HoHiep228/Project_Design-and-implementation-of-an-amplifier-circuit/Report_Design and implementation of an amplifier circuit..pdf

### ĐẠI HỌC QUỐC GIA THÀNH PHỐ HỒ CHÍ MINH

### TRƯỜNG ĐẠI HỌC BÁCH KHOA

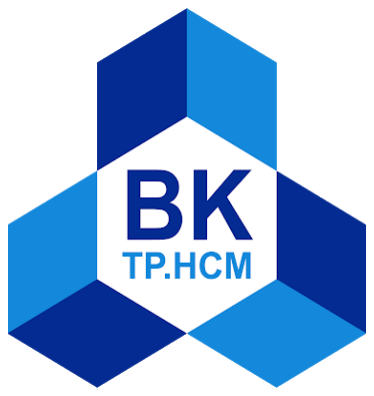
[picture p1: figure]

### BÁO CÁO BÀI TẬP LỚN MẠCH ĐIỆN TỬ

### THIẾT KẾ, THI CÔNG VÀ MÔ PHỎNG MẠCH KHUẾCH ĐẠI

Đáp ứng yêu cầu sau:

Trở kháng ngõ vào: > 100K.
Trở kháng ngõ ra: < 1K.
Nguồn ngõ vào trở kháng 1K, biên độ max 1Vpp.

Độ lợi áp: 5.
Băng thông: 15 Hz - 15 KHz.

Lớp: L01 - Nhóm: 07 - Học kỳ: 232

Giảng viên hướng dẫn: Đinh Quốc Hùng

Họ và tên | MSSV | Công việc | Đánh giá
Phạm Võ Hiệp | 2211051 | Lắp mạch thực tế | 25%
Phạm Lộ Hoàng Khang | 2211464 | Tính toán thiết kế | 25%
Nguyễn Đức Mạnh | 2211997 | Mô phỏng thiết kế | 25%
Trần Kim Phát | 2212536 | Báo cáo tổng hợp | 25%

Thành phố Hồ Chí Minh, ngày 23 tháng 04 năm 2024

## MỤC LỤC

PHẦN II. THIẾT KẾ, THI CÔNG VÀ MÔ PHỎNG MẠCH KHUẾCH ĐẠI.......8

1

### LỜI NÓI ĐẦU

Mạch điện tử là một trong những môn cơ sở ngành thể hiện vai trò vô cùng to

lớn để ứng dụng và phát triển chuyên sâu vào những môn chuyên ngành phía sau. Có

thể nói ở thời đại 4.0 này, hàng loạt các công nghệ hiện đại, phức tạp đều có một điểm

chung đó chính là phát triển từ các mạch điện tử cơ bản. Chỉ những linh kiện điện tử

bé nhỏ, nhưng đã thực hiện được hàng loạt các cuộc cách mạng trên toàn thế giới. Qua

các cuộc cách mạng công nghiệp, các linh kiện điện tử ngày càng được ứng dụng trong đời sống sản xuất cũng như sinh hoạt thường ngày.

Chính vì sự quan trọng ấy, nhóm chúng em vận dụng những kiến thức được học

tại lớp nhằm thực hiện bài tập lớn về thiết kế mạch khuếch đại. Mạch khuếch đại

thường được ứng dụng nhiều trong nhiều thiết bị, nhưng điển hình nhất, gần gũi nhất

với chúng ta đó chính là Ampli.

Vì thế, nhóm chúng em đã lên ý tưởng và bắt đầu tiến hành thiết kế mạch

khuếch đại này theo yêu cầu của đề tài được giao đó chính là:

- Trở khác ngõ vào: > 100K.
- Trở kháng ngõ ra: < 1K.
- Nguồn ngõ vào trở kháng 1K, biên độ max 1Vpp.
- Độ lợi áp: 5.
- Băng thông: 15 Hz - 15 KHz.

Trong quá trình báo cáo bài tập lớn cùng với việc thiết kế, thi công và mô

phỏng mạch khuếch đại sẽ không tránh những sai xót đang có. Do đó, nhóm chúng em

mong thầy sẽ đưa ra những lời nhận xét, để bài tập lớn này có thể hoàn thành đúng

như kỳ vọng cũng như được học hỏi thêm nhiều kiến thức áp dụng thực tế mai sau.

### PHẦN I

### CƠ SỞ LÝ THUYẾT

Mạch khuếch đại là mạch gồm các linh kiện điện tử cơ bản và một vài linh kiện

điện tử khác có chức năng khuếch đại cấu thành nên. Khi xuất hiện một tín hiệu từ ngõ

vào của mạch khuếch đại là dòng điện hoặc là điện áp, các linh kiện transistor thực

hiện công việc khuếch đại tín hiệu ngõ vào, sau đó tín hiệu đã được khuếch đại sẽ

được đưa ra ngõ ra và nối vào các ngoại vi tùy nhu cầu người thiết kế. Các phần tử

transistor dùng trong mạch khuếch đại chủ yếu là BJT, FET,... Hiện nay, để thiết kế

mạch khuếch đại, chúng ta có thể sử dụng nhiều phương pháp phụ thuộc vào nhu cầu

của người thiết kế có thể kể đến như: Mạch khuếch đại vi sai, mạch khuếch đại liên

tầng, ... Và nhóm chúng em quyết định sử dụng BJT để thực hiện bài tập lớn này, khi

sử dụng BJT, chúng ta cần phải quan tâm chú ý đến điểm làm việc tĩnh của loại BJT

lựa chọn sử dụng. Và để ứng dụng tính khuếch đại của BJT, ta cần thiết kế sao cho

điểm làm việc tĩnh này nằm trong vùng active mode.

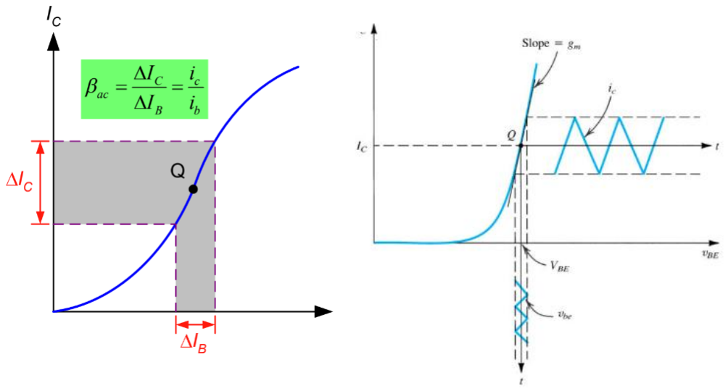
[picture p2: figure]

Ta đi vào tiến hành phân tích một số mạch khuếch đại sử dụng BJT.

1. Mạch khuếch đại cực E chung (Common Emmiter - CE).

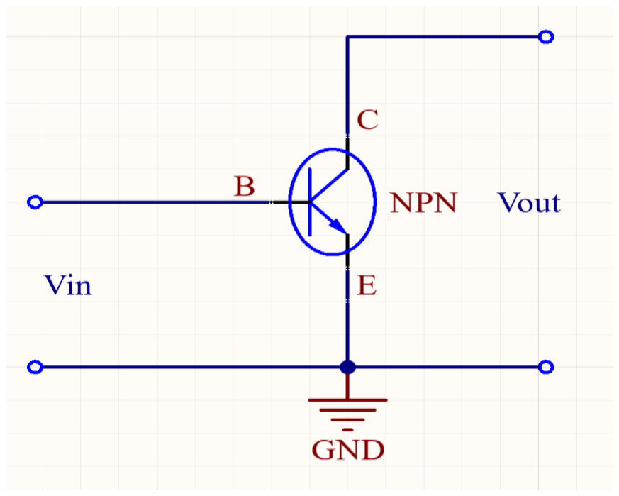
[picture p3: figure]

Mạch mắc theo kiểu cực E chung có các đặc điểm sau:

- Trở kháng ngõ vào (Rin) nhỏ.
- Trở kháng ngõ ra (Rout) lớn.
- Tín hiệu ngõ vào (Vin) là cực B.
- Tín hiệu ngõ ra (Vout) là cực C.
- Tín hiệu ngõ ra ngược pha so với tín hiệu ngõ vào.
- Khi mắc cực E chung, transistor có khả năng khuếch đại dòng điện, khuếch

đại điện áp, và khuếch đại công suất.

2. Mạch khuếch đại cực B chung (Common Base - CB).

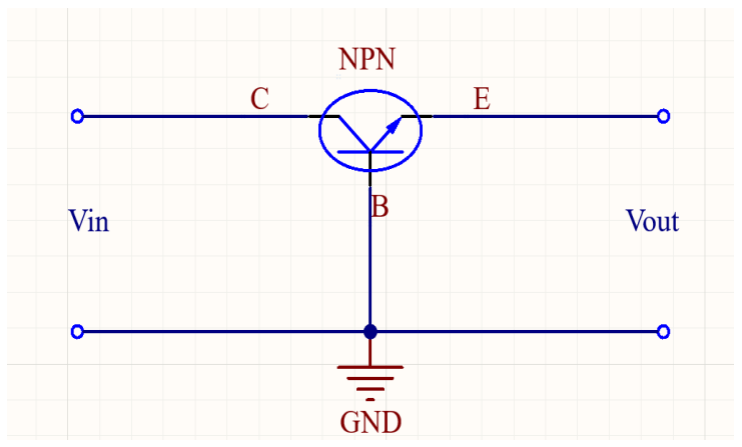
[picture p4: figure]

Mạch mắc theo kiểu cực B chung có các đặc điểm sau:

- Trở kháng ngõ vào (Rin) lớn.
- Trở kháng ngõ ra (Rout) lớn.

- Tín hiệu ngõ vào (Vin) là cực E.
- Tín hiệu ngõ ra (Vout) là cực C.
- Tín hiệu ngõ ra cùng pha so với tín hiệu ngõ vào.
- Khi mắc cực B chung, transistor có khả năng khuếch đại điện áp.
3. Mạch khuếch đại cực C chung (Common Collector - CC).

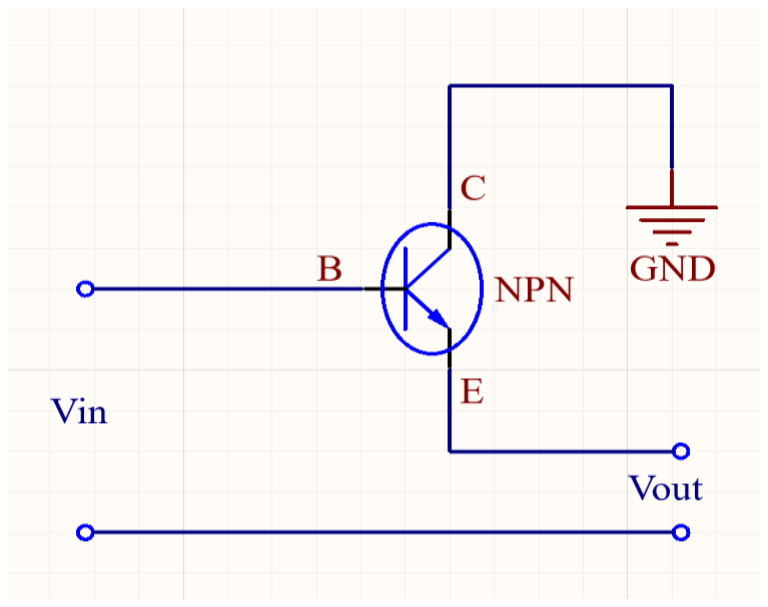
[picture p5: figure]

Mạch mắc theo kiểu cực C chung có các đặc điểm sau:

- Trở kháng ngõ vào (Rin) lớn.
- Trở kháng ngõ ra (Rout) nhỏ.
- Tín hiệu ngõ vào (Vin) là cực B.
- Tín hiệu ngõ ra (Vout) là cực E.
- Tín hiệu ngõ ra cùng pha so với tín hiệu ngõ vào.
- Khi mắc cực C chung, transistor có khả năng khuếch đại dòng điện.
4. Mạch khuếch đại ghép liên tầng.

Trong thực tế, việc sử dụng một mạch khuếch đại đơn có thể không đáp ứng đủ

độ lợi theo yêu cầu. Ví dụ, một hệ thống loa trong hệ thống khuếch đại âm thanh có

chứa nhiều mạch khuếch đại liên tầng nhằm để nâng mức tín hiệu gốc từ microphone

lên đến mức hiệu quả để cho ra một công suất đủ lớn tại loa. Sau đây là sơ đồ khối mô

tả mạch khuếch đại ghép liên tầng:

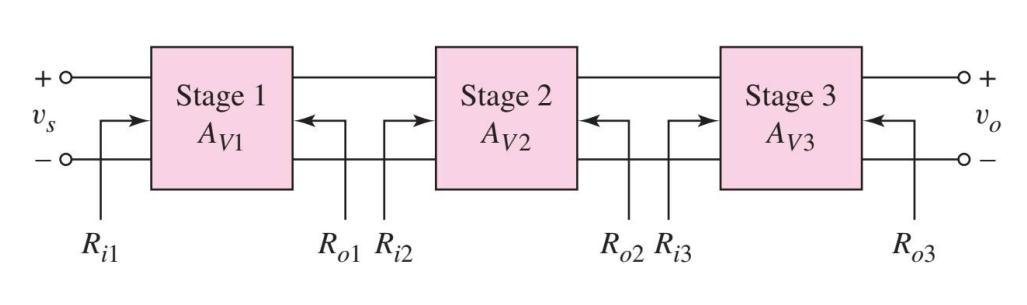
[picture p6: figure]

Một số mạch khuếch đại ghép liên tầng như: Mạch khuếch đại Cascade, mạch

khuếch đại Cascode, mạch khuếch đại Darlington, mạch khuếch đại vi sai.

4.1. Mạch khuếch đại Cascade.

Là mạch gồm nhiều mạch khuếch đại nối tiếp với nhau. Ngõ ra của mạch

khuếch đại này là ngõ vào của mạch khuếch đại tiếp theo.

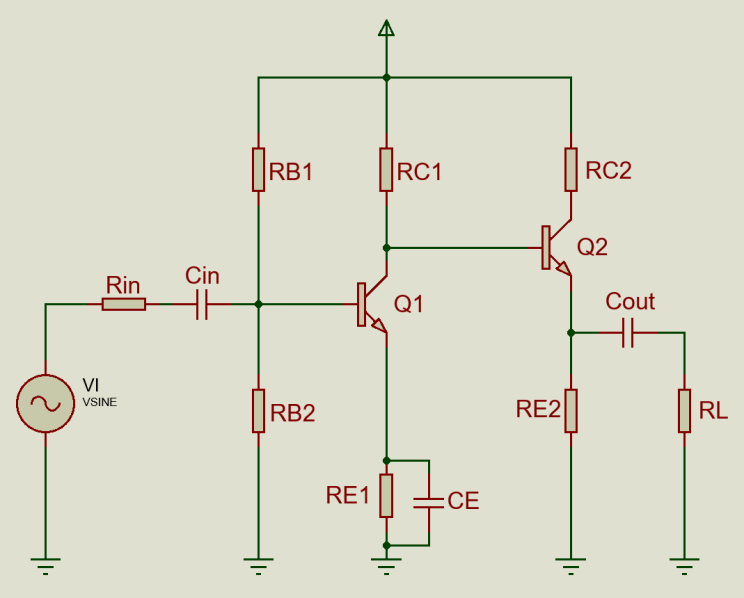
[picture p7: figure]

4.2. Mạch khuếch đại Cascode.

Là mạch ghép từ một mạch khuếch đại CE và một mạch khuếch đại CB. Tín

hiệu vào cấp cho mạch CE, tín hiệu ra lấy từ mạch CB. Ưu điểm lớn nhất của mạch là

có đáp ứng tần số tốt hơn các kiểu mạch ghép khác, cũng như tốt hơn mạch khuếch đại

đơn tầng.

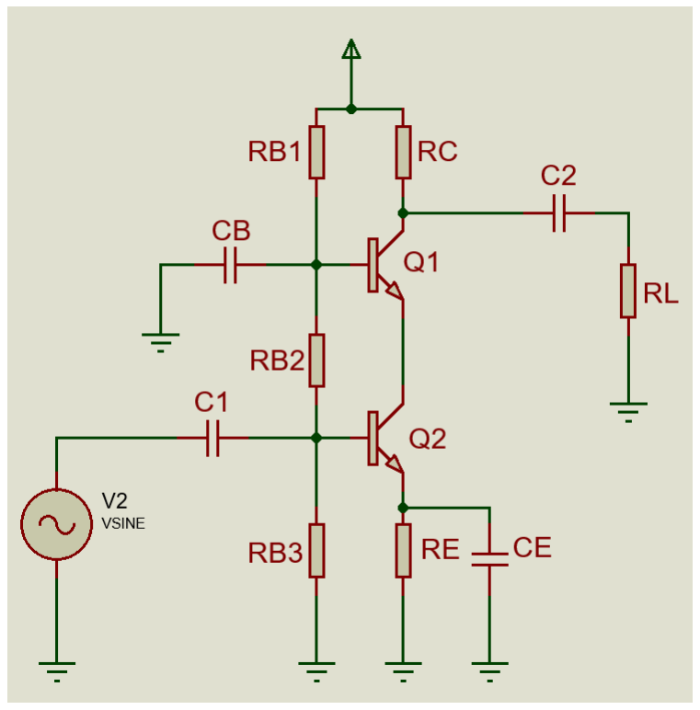
[picture p8: figure]

4.3. Mạch khuếch đại Darlington.

Là mạch dùng 2 BJT ghép chung và cực E của BJT này ghép nối tiếp với cực B

của BJT kia. Có thể xem như tương đương với 1 BJT với hfe = β1β2

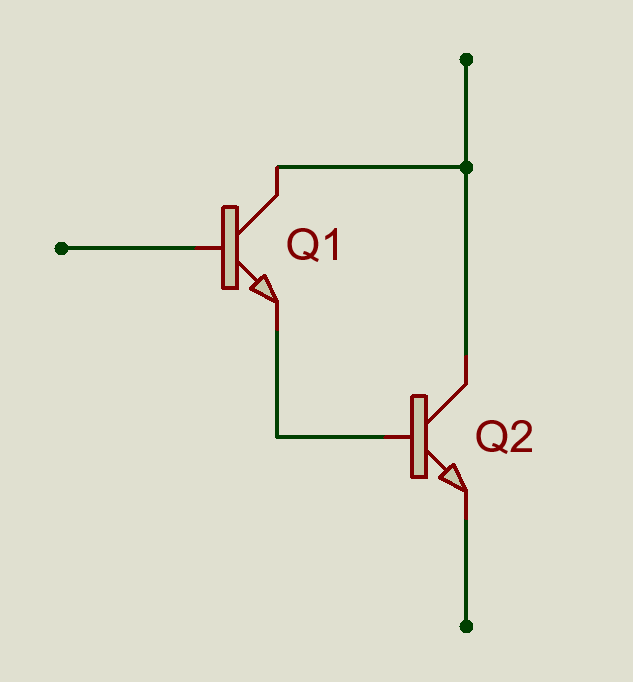
[picture p9: figure]

4.4. Mạch khuếch đại vi sai.

Là mạch gồm 2 BJT hoàn toàn giống nhau về mặt giá trị cũng như thông

số ngõ vào ngõ ra (mạch đối xứng). Nguồn dòng cực E xem như nguồn dòng lý

tưởng với trở khánh → ∞. Có thể sử dụng RE thay cho cho nguồn dòng.

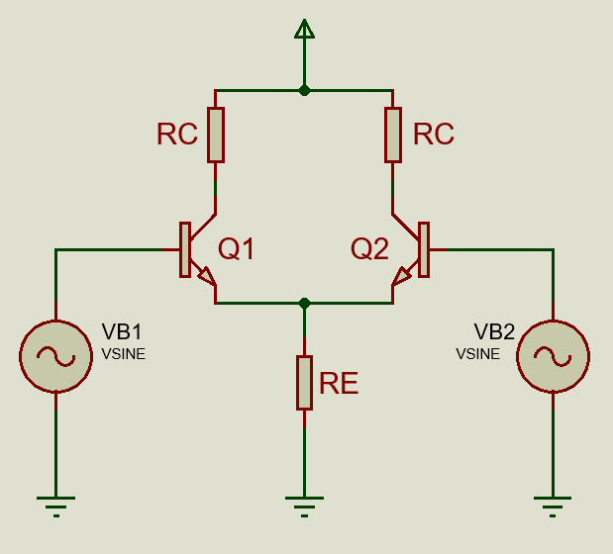
[picture p10: figure]

5. Khái niệm ghép RC.

Khi ta ghép các tụ, các tụ sẽ có chức năng chính đó là cho nguồn xoay chiều đi

qua, cách ly nguồn DC giữa các tầng ghép, và tạo tần số đủ cao để giữ cho giá trị điện

kháng XC nhỏ. Nhưng khi ta ghép RC, nó sẽ tác động đến những tín hiệu có tần số thấp,

sẽ xuất hiện những tổn hao xảy ra trên những tụ điện này, và vì thế cần phải lựa chọn

tụ có điện dung lớn và một tần số cắt thấp nhỏ.

### PHẦN II

### THIẾT KẾ, THI CÔNG VÀ MÔ PHỎNG MẠCH KHUẾCH ĐẠI

1. Thiết kế, thi công mạch khuếch đại theo yêu cầu đề bài.

Sau khi phân tích phần cơ sở lý thuyết nêu trên, nhóm chúng em đã quyết định

thiết kế mạch theo sơ đồ mạch khuếch đại Cascade. Để thiết kế một mạch khuếch đại

dùng BJT, ta cần nắm rõ tính toán các thông số của BJT phù hợp với nhu cầu sử dụng.

Vì vậy, sau khi bàn bạc, thảo luận và đóng góp ý kiến thì nhóm chúng em quyết định

sử dụng 2 linh kiện BJT BC547B (Q1 và Q2).

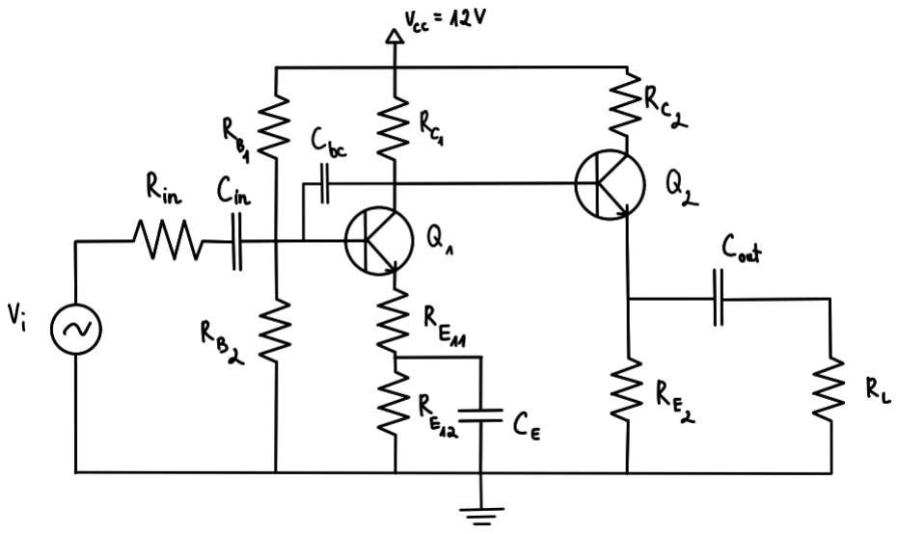
[picture p11: figure]

Đầu tiên, chọn điều kiện làm việc tĩnh cho Q1 (VCE,ICQ) = (4,5 V; 0,4 mA).

Tại đó, ta có giá trị hfe = 300 nên ta suy ra được giá trị hie của Q1 bằng công thức:

ℎie1 = ℎfe.

VT

ICQ

= 300.

0,025
0,4. 10⁻³ = 18,75KΩ

Tiếp theo đó, ta chọn RE1 = 3000Ω và chia làm 2 phần đó là RE11 và RE12 lần

lượt có giá trị là 2500Ω và 500Ω (Do chọn VE ~

1
10

VCC). Ta có mạch như sau:

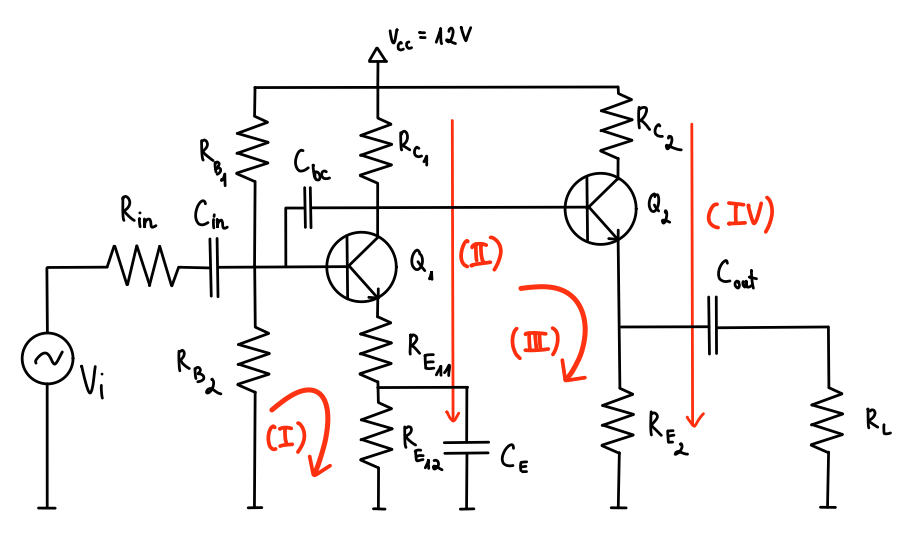
[picture p12: figure]

Theo Thevanin, ta tính được giá trị của VB và RB lần lượt là: VB =

VCC .RB2

RB1+RB2

và

RB =

RB1 .RB2

RB1+RB2

Theo KVL (I), ta có phương trình:

VB − Vγ − IB .RB = VE

VCC . RB2

RB1 + RB2

− 0,7 −

ICQ
ℎfe .

RB1

. RB2

RB1 + RB2

= ICQ .

ℎfe + 1
ℎfe . RE1

Ta chọn RB2 = 330KΩ để đảm bảo Zin > 100K.

=>

12 . 330K
RB1 + 330K

− 0.7 −

0,4.10⁻³
300 .

RB1

. 330K
RB1 + 330K

= 0,4.10⁻³

300 + 1
300 . 3000

=> RB1 = 1421KΩ → Chọn RB1 = 1425KΩ để đảm bảo sai số.

Theo KVL (II), ta có phương trình:

VCC = VC + VCE + VE = ICQ . RC1 + VCE + ICQ .

ℎfe + 1
ℎfe . RE

=> RC1 =

VCC − VCE − ICQ.

ℎfe + 1
ℎfe . RE

ICQ

=

12 − 4,5 − 0,4. 10⁻³

301
300 . 3000
0,4. 10⁻³

=> RC1 = 15740Ω → Chọn RC1 = 15KΩ.

Kiểm chứng lại dòng để phân cực cho BJT:

I =

VCC

RB1 + RB2

=

12
1425K + 330K

= 6,84μA > IB =

ICQ
ℎfe = 1,33μA

Theo KVL (III), ta có phương trình:

VC1 ≈ VB2 (IB2 ≪ ICQ1)

VB2 − Vγ = VE => VE = VC1 − Vγ = VCC − ICQ1

. RC1 − Vγ

= 12 − 0,4. 10⁻³
. 15K − 0,7 = 5,3 (V)

Sau khi đã tính toán các thông số trở nối với các cực của Q1, ta tiếp tục tính

toán các thông số liên quan đến BJT Q2. Cũng giống như BJT Q1, ta cần chọn điều

kiện tĩnh của Q2 (VCE,ICQ) = (5 V; 5 mA). Ta tính được trở cần mắc vào cực E của

BJT Q2.

RE2 =

VE

IEQ

≈

VE

ICQ2

=

5,3
5. 10⁻³

≈ 1K Ω

Theo KVL (IV), ta có phương trình:

RC2 =

VCC − VCE − VE2

ICQ2

=

12 − 5 − 5,3
5. 10⁻³ = 340 Ω

→ Chọn RC2 = 400 Ω

Vì RB1 // RB2 nên ta có:

RB =

RB1

. RB2

RB1 + RB2

=

1425K. 330K 1425K + 330K | ≈ 270 KΩ

Vậy là chúng ta đã có toàn bộ giá trị của điện trở trong mạch, tiếp theo đó, ta

bắt đầu đi tính độ lợi của mạch khuếch đại Cascade này.

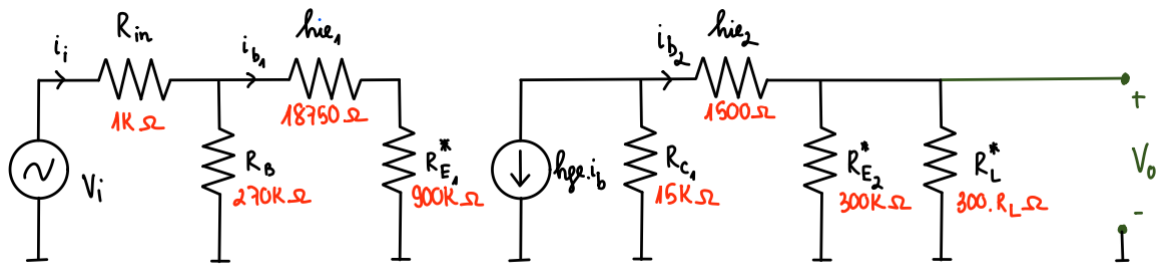
[picture p13: figure]

Độ lợi của mạch là:

AV =

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
= (RE2

∗
//RL

∗
) ∙

RC1. (−ℎfe)
RC1 + ℎie2 + RE2

∗
//RL

∗

∙

RB
RB + ℎie1 + RE1

∗

∙

1
Rin + [RB//(ℎie1 + RE1

∗
)]

Đặt RE2

∗
//RL

∗ = X, ta có:

AV =

−ℎfe . RC1
RC1 + ℎie2
X

+ 1

∙

RB
RB + ℎie1 + RE1

∗

∙

1
Rin + [RB//(ℎie1 + RE1

∗
)]

=

−300 . 15K
15K + 1.5K
X

+ 1

∙

270K
270K + 18,75K + 900K

∙

1
1K + [270K//(918,75K)]

= −5

<=> X ≫ 15K + 1.5K → Chọn RL = 16 KΩ

Vậy sau khi thiết kế và tính toán, ta tính lại các giá trị trở ngõ ra, trở ngõ vào như

sau:

Zin = RB//(ℎie1 + RE1

∗
) =

270K. (18,75K + 900K)
270K + (18,75K + 900K)

= 208675Ω > 100 KΩ

Zout =

RE2

∗
//(RC1 + ℎie2)
ℎfe | =

300K. (15K + 1,5K)
300K + (15K + 1,5K)
300 | = 52,13Ω < 1KΩ

Vậy giá trị trở ngõ ra và ngõ vào đều thỏa mãn yêu cầu thiết kế.

Xét mạch ở đáp ứng tần số thấp, ta có:

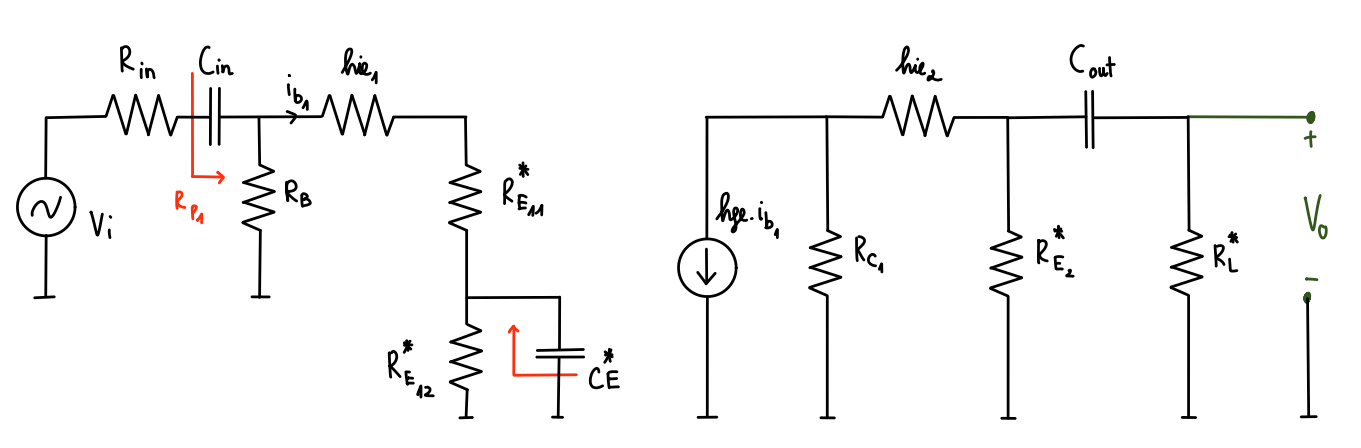
[picture p14: figure]

AV = Am ∙

1 + ωZ1
1 + ωP1

∙

1 + ωZ2
1 + ωP2

∙

1 + ωZ3
1 + ωP3
- Xét tụ Cin:
{

RZ1 = ∞ => ωZ1 = 0

RP1 =

RB(ℎie1 + RE1

∗
)
RB + (ℎie1 + RE1

∗
)

+ Rin =

270K(18.75K + 900K)
270K + (18.75K + 900K)

+ 1K = 209675

=> ωP1 =

1

RP1

. Cin

= 15.2π

=> Cin =

1

RP1

. 15.2π

=

1
209675.15.2π

= 5,06. 10⁻⁸
(F)

→ Chọn tụ có giá trị điện dung là 50nF.

- Xét tụ Cout:
{

RZ2 = ∞ => ωZ2 = 0

RP2 =

RL

∗ + [

RE2

∗
(ℎie2 + RC1)
RE2

∗ + (ℎie2 + RC1
)

]
ℎfe | =

4800K + [

300K(1.5K + 15K)
300K + (1.5K + 15K)

]
300 | = 16052Ω

=> ωP2 =

1

RP2

. Cout

= 15.2π

=> Cout =

1

RP2

. 15.2π

=

1
16052.15.2π

= 0,67. 10⁻⁶
(F)

→ Chọn tụ có giá trị điện dung là 0,68μF.

- Xét tụ CE:

Đặt: Y = RE11

∗ + ℎie1 + RB//Rin

<=> Y = 2500.300 + 18750 +

270K. 1K
270K + 1K

= 769746,31Ω

{

RZ3 = RE12

∗ = 150KΩ => ωZ3 =

1
150K. 25,356. 10⁻⁶ = 0,2629 ≈ 0

RP3 =

Y. RE12

∗
Y + RE12

∗
ℎfe =

769746,31.500.300
769746,31 + 500.300
300 | = 418,456Ω => ωP3 =

1
418,456. CE

= 2π. 15

=> CE =

1
418,456.2π. 15 = 25,356μF

→ Chọn tụ CE có giá trị điện dung là 25μF.

Xét mạch ở đáp ứng tần số cao, ta có:

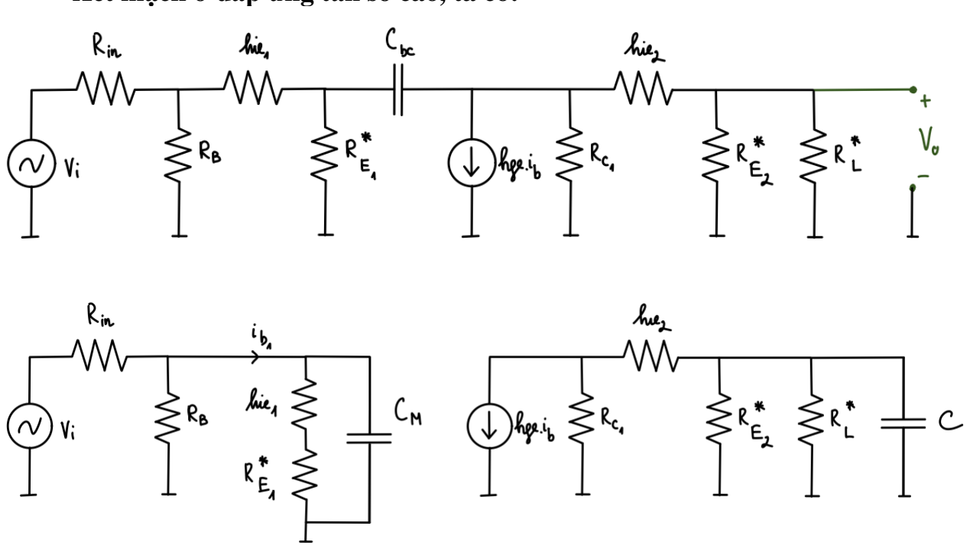
[picture p15: figure]

- Xét tụ CM:
{

RZ1 = 0 => ωZ1 = ∞
RP1 = (
1
RB

+

1
ℎie1 + RE11

∗ +

1

Rin)

−1
= (

1
270K

+

1
18,75K + 2500.300 +

1
1K

)

−1
= 995Ω

Nếu dùng CBE của BJT BC547B thì CBE có giá trị bằng 9pF.

=> f =

1
2π. RP1

. CBE

=

1
2π. 995.9. 10⁻¹² = 17,77 MHz

Mà theo yêu cầu đề bài, giá trị băng thông tối đa là: 15KHz < 0,3f = 5,331 MHz

=>Tụ CBE và CBC chưa hoạt động. Vì thế, ta cần mắc thêm 1 tụ điện giữa cực B và cực C.

Ta đi tìm giá trị gm.

gm =

ICQ
VT

=

0,4. 10⁻³
25. 10⁻³ = 0.016

K =

V2
V1

= −gm ∙

RC1

[ℎie2 + (

RE2

. RL
RE2 + RL

)]

RC1 + [ℎie2 + (

RE2

. RL
RE2 + RL

)]

= −0.016 ∙

15K [1500 + (

1K. 16K
1K + 16K

)]

15K + [1500 + (

1K. 16K
1K + 16K

)]

= −33,6

CM = (1 + gm ∙
RC1

[ℎie2 + (

RE2

. RL
RE2 + RL

)]

RC1 + [ℎie2 + (

RE2

. RL
RE2 + RL

)]

) . C

= (1 + 0.016 ∙
15K [1500 + (

1K. 16K
1K + 16K

)]

15K + [1500 + (

1K. 16K
1K + 16K

)]

). C = 34,6C

=> fH =

1

RP1

. 34,6C

=

1
995.34,6C

= 2π. 15K => CC = 550pF

→ Chọn tụ CC có giá trị điện dung là 550pF.

2. Mô phỏng mạch khuếch đại trên LTspice.

Để kiểm chứng với những kết quả trên, nhóm chúng em tiến hành thực hiện mô

phỏng, đo đạc các thông số trên phần mềm LTspice để so sánh các kết quả với nhau.

Đầu tiên, giống như phần trước thì chúng em sẽ tiến hành đo các thông số của BJT ở

điều kiện làm việc tĩnh. Để đo các thông số IC, IB, IE, VB, VC, VE, ta đo ở chế độ DC,

tức hở mạch các tụ điện và ngắn mạch cuộn cảm nếu có. Ta cần đặt các label tại các

chân BJT ngoài ra ta có thể sử dụng vontage ( đặt giá trị 0V ) và xem vontage như một

Ampe kế để đo dòng điện.

Đo mạch ở chế độ DC:

Ta chọn Simulate sau đó chọn Configure Analysis rồi chọn DC op pnt.

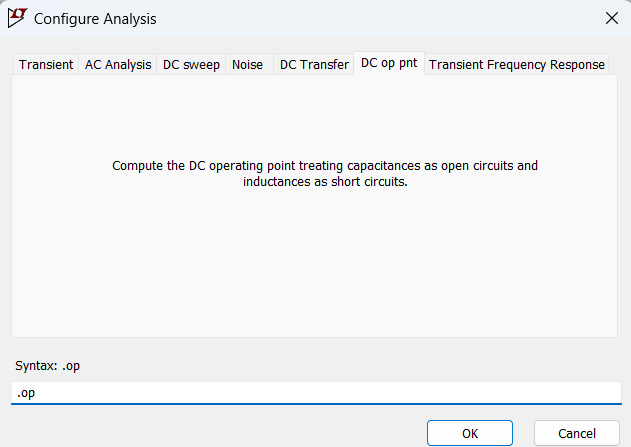
[picture p16: figure]

Tiến hành vẽ mạch mô phỏng trên phần mềm LTspice, mạch gồm 2 BJT

BC547B được mắc theo kiểu mạch khuếch đại Cascade. Các giá trị sau khi đã chọn ở

phần trên, ta tiến hành chạy mô phỏng để kiểm nghiệm lại các kết quả tính toán. Sau

đây là sơ đồ mạch trong LTspice của nhóm chúng em.

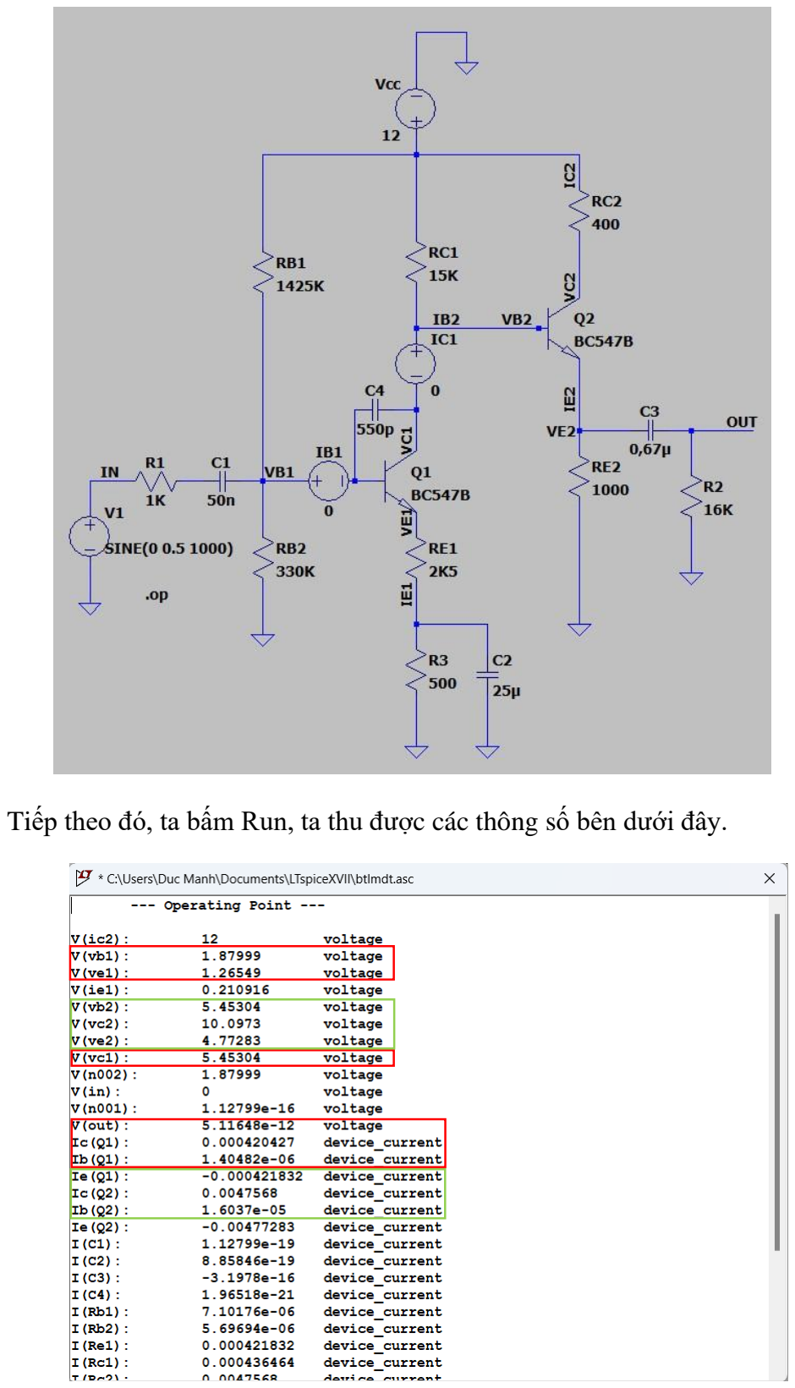
[picture p17: page 18]

Tiếp theo đó, ta bấm Run, ta thu được các thông số bên dưới đây.

Transistor Q1:

+ Chênh lệch điện áp giữa hai chân B và E đo được: VBE = VB − VE = 1,87999 − 1,26549 = 0,6145(V)

+ Điện áp phân cực tĩnh:
VCE = VC − VE = 5,45304 − 1,26549 = 4,18755(V)

+ Dòng ICQ đo được: ICQ = 0,420427(mA).

+ Xác định hệ số khuếch đại dòng Q1:

ℎfe =

IC
IB

=

0,420427 × 10⁻³
1,40482 × 10⁻⁶ = 299,2746402 ≈ 300

Qua đó, ta xác định được điểm hoạt động của BJT Q1: Q1(4,19V; 0,42mA).

Transistor Q2:

+ Chênh lệch điện áp giữa hai chân B và E đo được:
VBE = VB − VE = 5,45304 − 4,77283 = 0,68021(V)

+ Điện áp phân cực tĩnh:
VCE = VC − VE = 10,0973 − 4,77283 = 5,32447(V)

+ Dòng ICQ đo được: ICQ = 4,7568(mA).

+ Xác định hệ số khuếch đại dòng Q2:

ℎfe =

IC
IB

=

4,7568 × 10⁻³
1,6037 × 10⁻⁵ = 296,6140799 ≈ 300

Qua đó, ta xác định được điểm hoạt động của BJT Q2: Q2(5,32V; 4,8mA).

Đo độ lợi áp:

Ta có công thức độ lợi áp: Av =

Vout

Vin

. Để tính được độ lợi áp ta cần giá trị Vout

và Vin do đó ta sẽ mô phỏng dạng sóng ngõ vào và ngõ ra.

Đặt giá trị cho nguồn Vin.

Nguồn Vin ta chọn SINE trong functions, Vpp=1V nên ta đặt giá trị 0.5V cho

Amplitude và tần số 1000 Hz cho Freq.

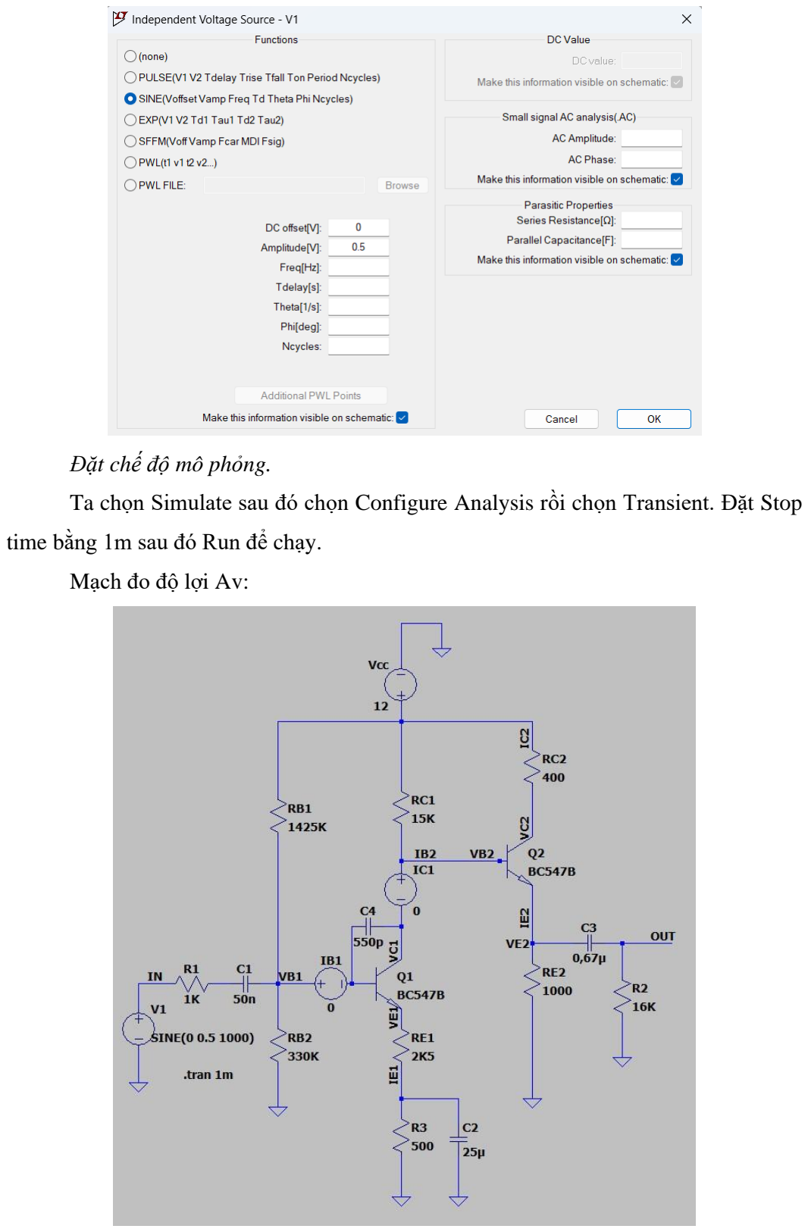
[picture p18: page 20]

Đặt chế độ mô phỏng.

Ta chọn Simulate sau đó chọn Configure Analysis rồi chọn Transient. Đặt Stop

time bằng 1m sau đó Run để chạy.

Mạch đo độ lợi Av:

Kết quả thu được:

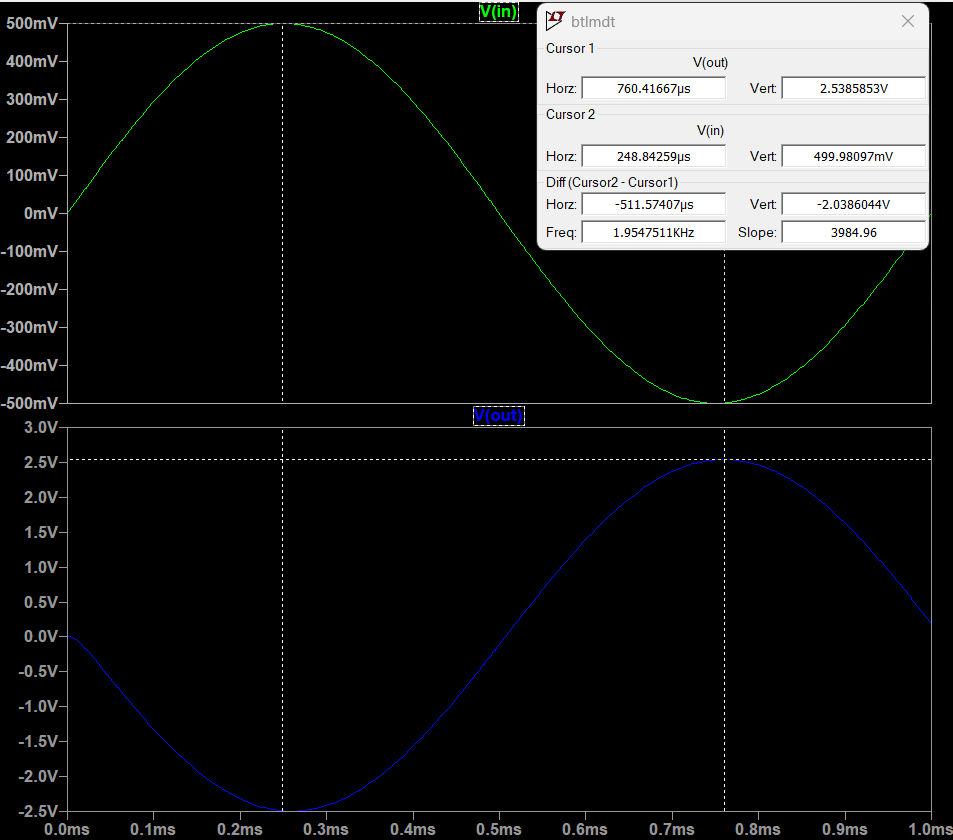
[picture p19: figure]

Qua đó, ta đo được giá trị Vout = 2,5385853V và Vin = 0,499V.

Ta có công thức độ lợi áp:

|Av

| = |

Vout

Vin

| =

2,5385853
0,499 = 5,087345291(V/V)

Do ngược pha nên Av = −5,08734529(V/V).

Theo lý thuyết Av = −5(V/V).

Ta tính được sai số: ~1,75%.

Đo tần số thấp và tần số cao:

Đặt chế độ nguồn cho Vin.

Ta chỉnh nguồn áp ở chế độ Small signal analysis (AC ) với Amptilute là 0.5.

Đặt chế độ mô phỏng.

Ta chọn Simulate sau đó chọn Configure Analysis rồi chọn AC Analysis:

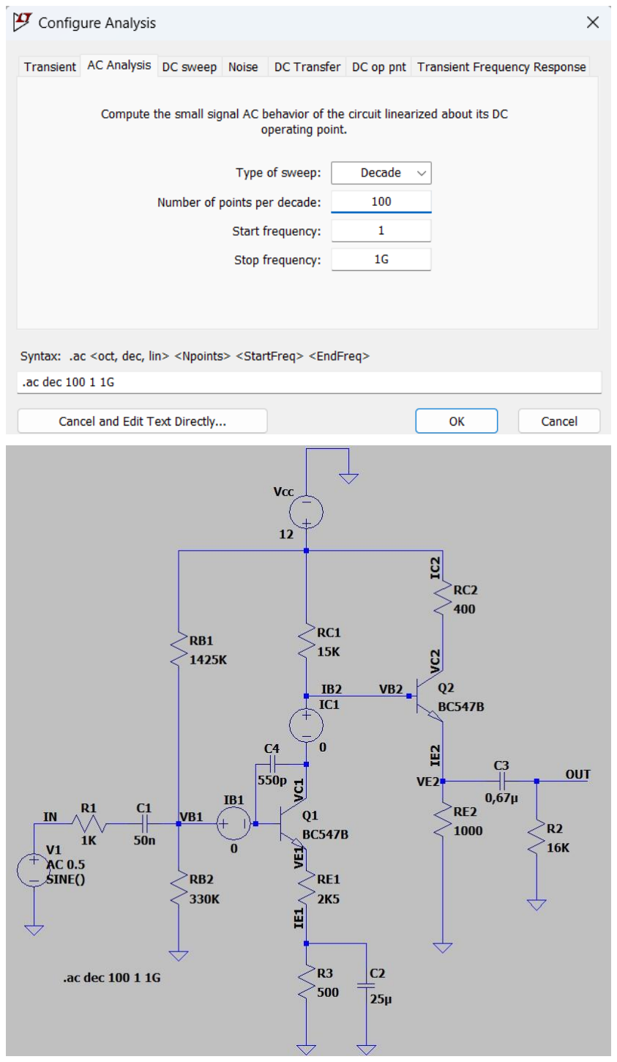
[picture p20: page 22]
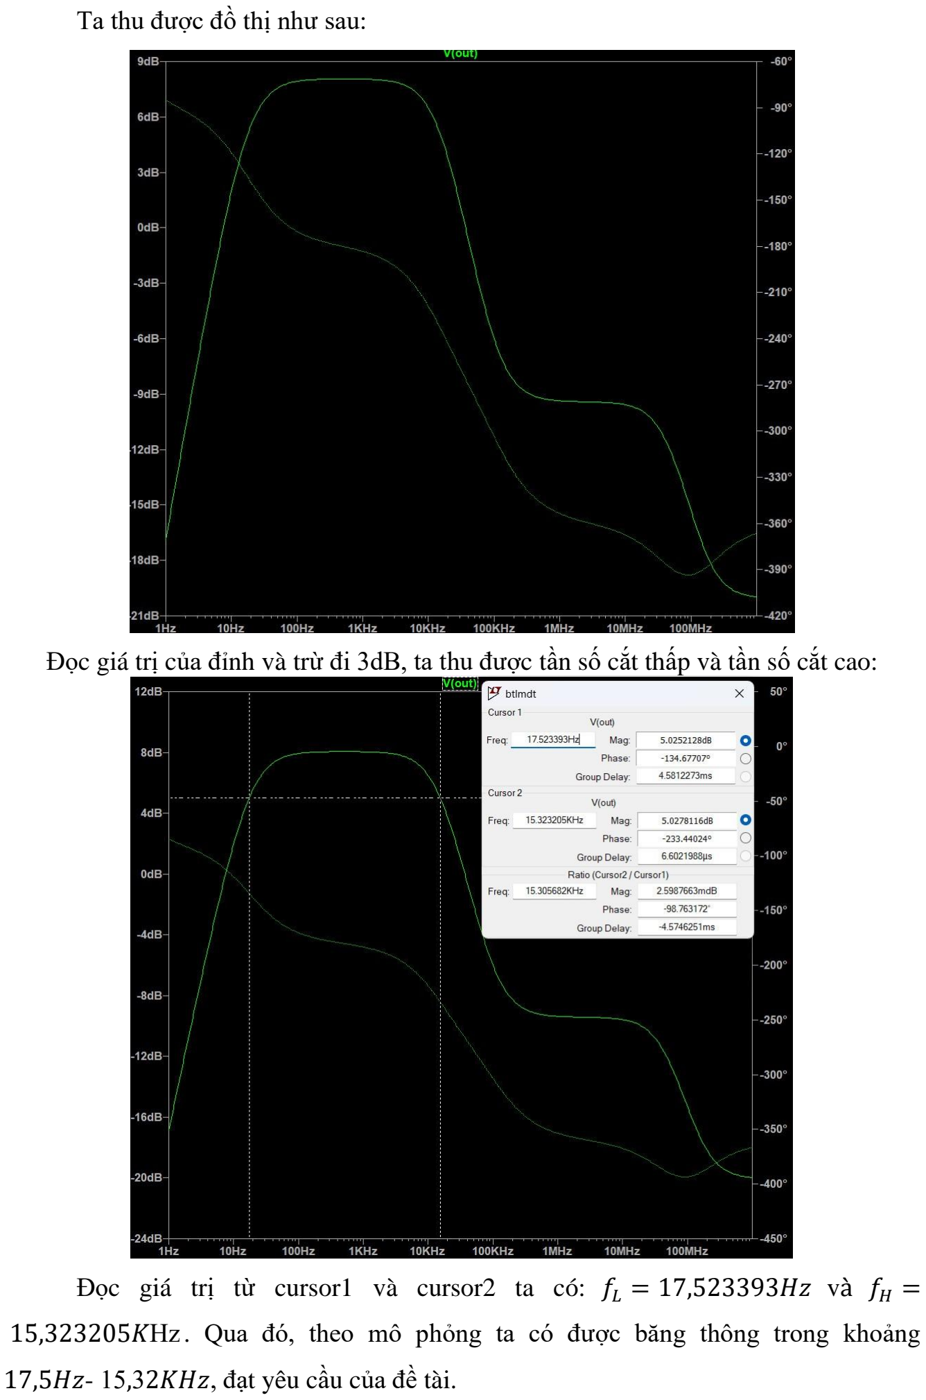
[picture p21: page 23]

Ta thu được đồ thị như sau:

Đọc giá trị của đỉnh và trừ đi 3dB, ta thu được tần số cắt thấp và tần số cắt cao:

Đọc giá trị từ cursor1 và cursor2 ta có: fL = 17,523393Hz và fH =

15,323205KHz . Qua đó, theo mô phỏng ta có được băng thông trong khoảng

17,5Hz- 15,32KHz, đạt yêu cầu của đề tài.

3. Lắp đặt thực tế và thực hiện đo đạc qua máy phát sóng.

Sau khi tiến hành thực hiện các bước tính toán, thiết kế và mô phỏng mạch

khuếch đại, nhóm chúng em bắt đầu tiến hành sử dụng các linh kiện được chọn phía

trên để lắp đặt trên breadboard như hình vẽ sau:

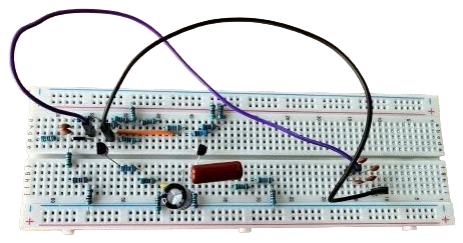
[picture p22: figure]

Tiếp theo, ta kết nối mạch với máy phát sóng hình sine, tăng dần tần số từ 15Hz

lên, ta thu được độ lợi Am lớn nhất ở tần số 1,00587 kHz tương ứng với Hình 1.

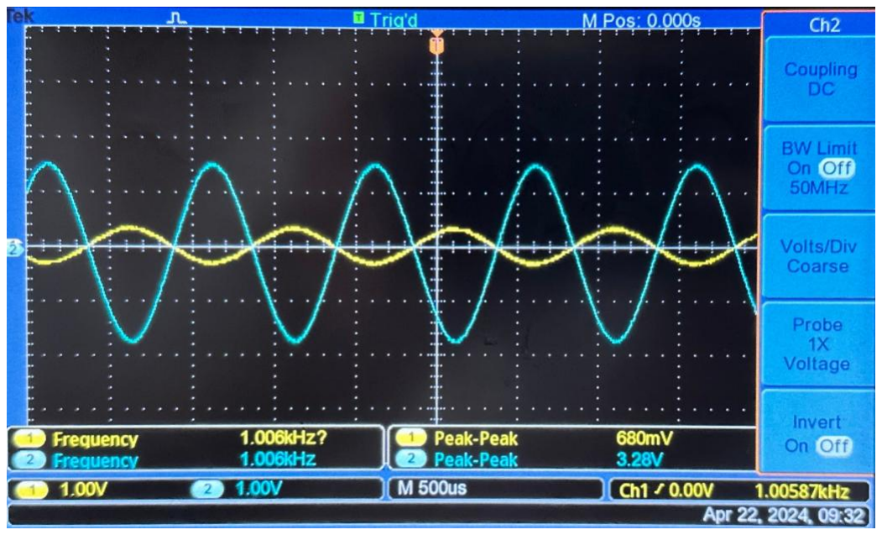
[picture p23: figure]

Hình 1: Độ lợi lớn nhất thu được trên Oscilloscope.

Từ độ lợi lớn nhất Am, ta giảm tần số liên tục cho đến khi thu được độ lợi mới

có giá trị

Am
√2

. Ta thu được tần số cắt thấp fL = 23,4269 Hz.

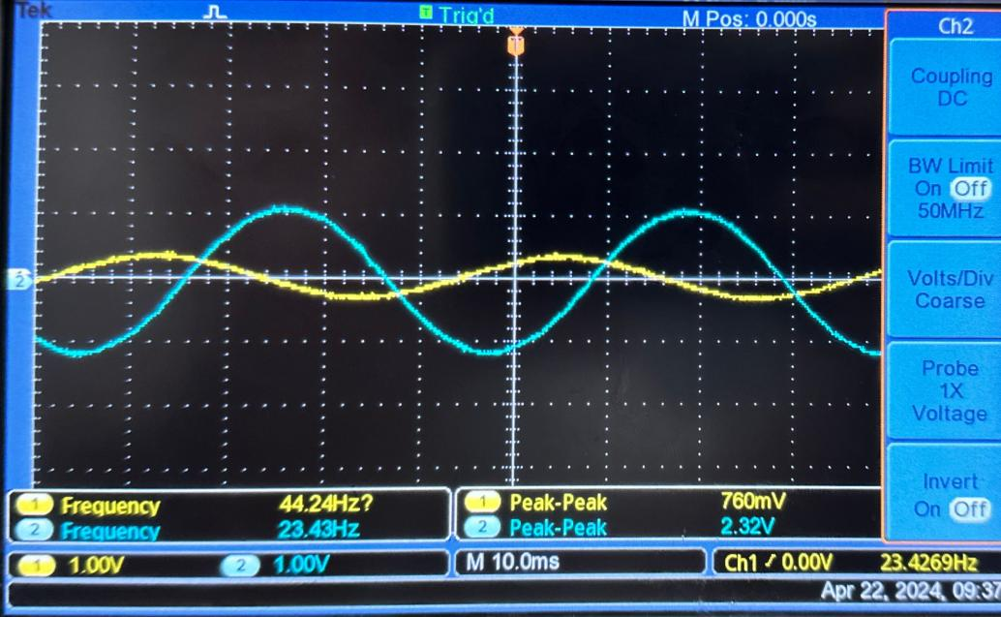
[picture p24: figure]

Hình 2: Tần số cắt thấp thu được trên Oscilloscope.

Từ độ lợi lớn nhất Am, ta tăng tần số liên tục cho đến khi thu được độ lợi mới

có giá trị

Am
√2

. Ta thu được tần số cắt cao fH = 15,0729 kHz.

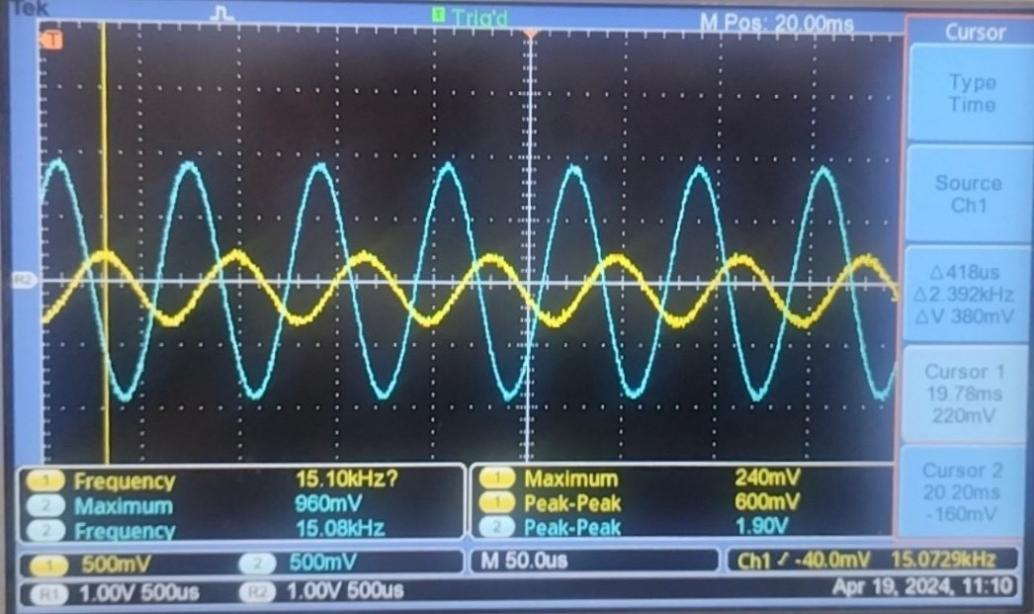
[picture p25: figure]

Hình 3: Tần số cắt cao thu được trên Oscilloscope.

### LỜI KẾT THÚC

Trong thời gian thực hiện bài tập lớn mạch điện tử vừa qua, nhóm chúng em đã được tiếp xúc nhiều hơn với các phần mềm mô phỏng, các linh kiện điện tử và đặc biệt

là khâu tính toán thiết kế. Sau khi được sự hướng dẫn của thầy qua các giờ học lý

thuyết vào lúc 9 giờ sáng thứ 2 hàng tuần, nhóm chúng em đã từng bước đề ra những

kế hoạch cụ thể và phân công nhiệm vụ hợp lý cho từng thành viên trong nhóm. Để có

được một kết quả độ lợi gần bằng 5, trở kháng ngõ vào, ngõ ra và băng thông đều đáp

ứng được theo yêu cầu đề tài, đó là một sự nỗ lực, đoàn kết, không ngừng trau dồi

thêm tri thức của các thành viên trong nhóm. Tuy nhiên, trong lúc thực hiện mạch đôi lúc gặp nhiều thử thách không thể lường trước được. Vì thế, sau khi đã đọc qua bài

báo cáo này, nhóm chúng em mong nhận được những lời góp ý vô cùng quý báu của thầy cũng như những lời nhận xét, để chúng em có thể hoàn thiện hơn sản phẩm bài

tập lớn này nói riêng và các kiến thức liên quan đến mạch điện tử nói chung.

Sau hết, nhóm chung em xin cảm ơn thầy một cách chân thành nhất vì đã tận

tình hướng dẫn, chỉ bảo chúng em trong suốt thời gian qua. Chúc thầy thật nhiều sức

khỏe và luôn thành công trong cuộc sống.
