HoHiep228/Project_Design-and-implementation-of-an-amplifier-circuit/Presentation Slide.pdf

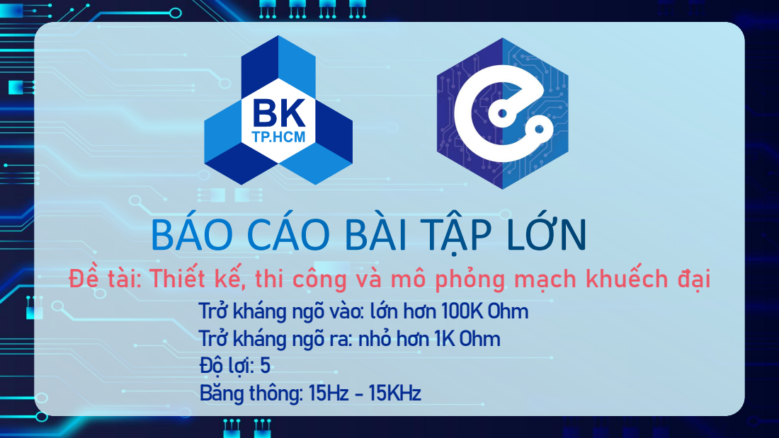
[picture p26: page 1]

BÁO CÁO BÀI TẬP LỚN

Đề tài: Thiết kế, thi công và mô phỏng mạch khuếch đại

Trở kháng ngõ vào: lớn hơn 100K Ohm
Trở kháng ngõ ra: nhỏ hơn 1K Ohm
Độ lợi: 5
Băng thông: 15Hz - 15KHz

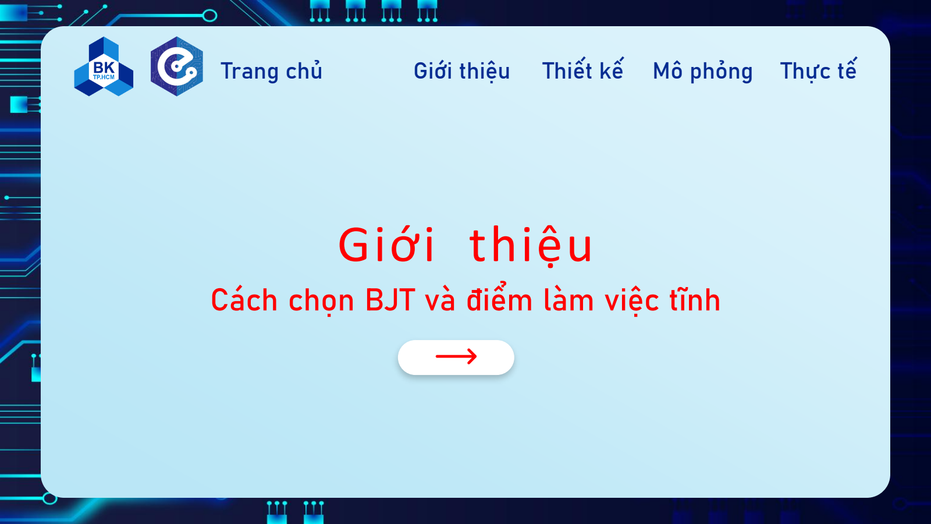
[picture p27: page 2]

## Cách chọn BJT và điểm làm việc tĩnh

# Giới thiệu

Trang chủ | Giới thiệu | Thiết kế Mô phỏng Thực tế

## Giới thiệu

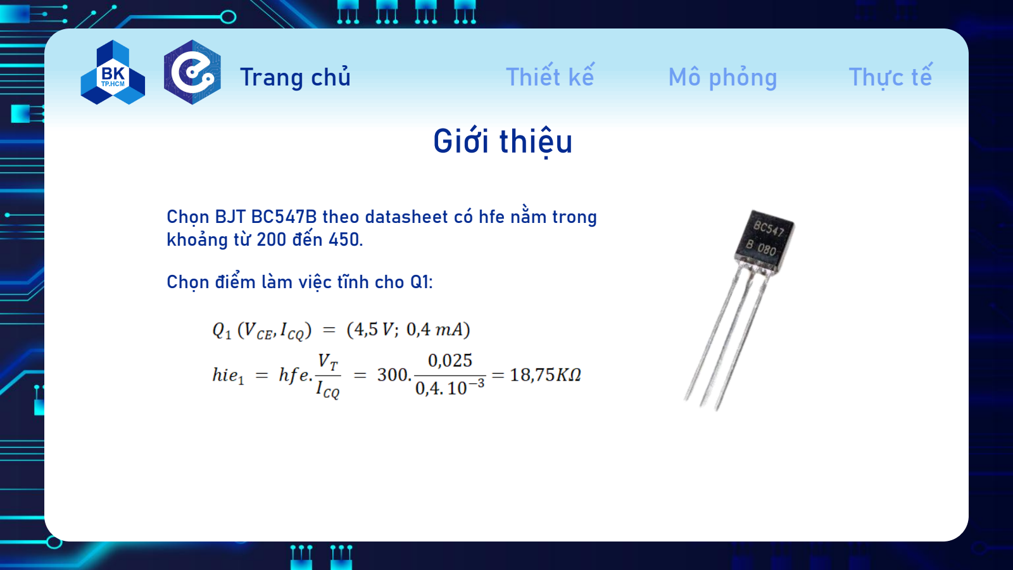
[picture p28: page 3]

Trang chủ

Thiết kế | Mô phỏng | Thực tế

Chọn BJT BC547B theo datasheet có hfe nằm trong khoảng từ 200 đến 450.

Chọn điểm làm việc tĩnh cho Q1:

## Thiết kế

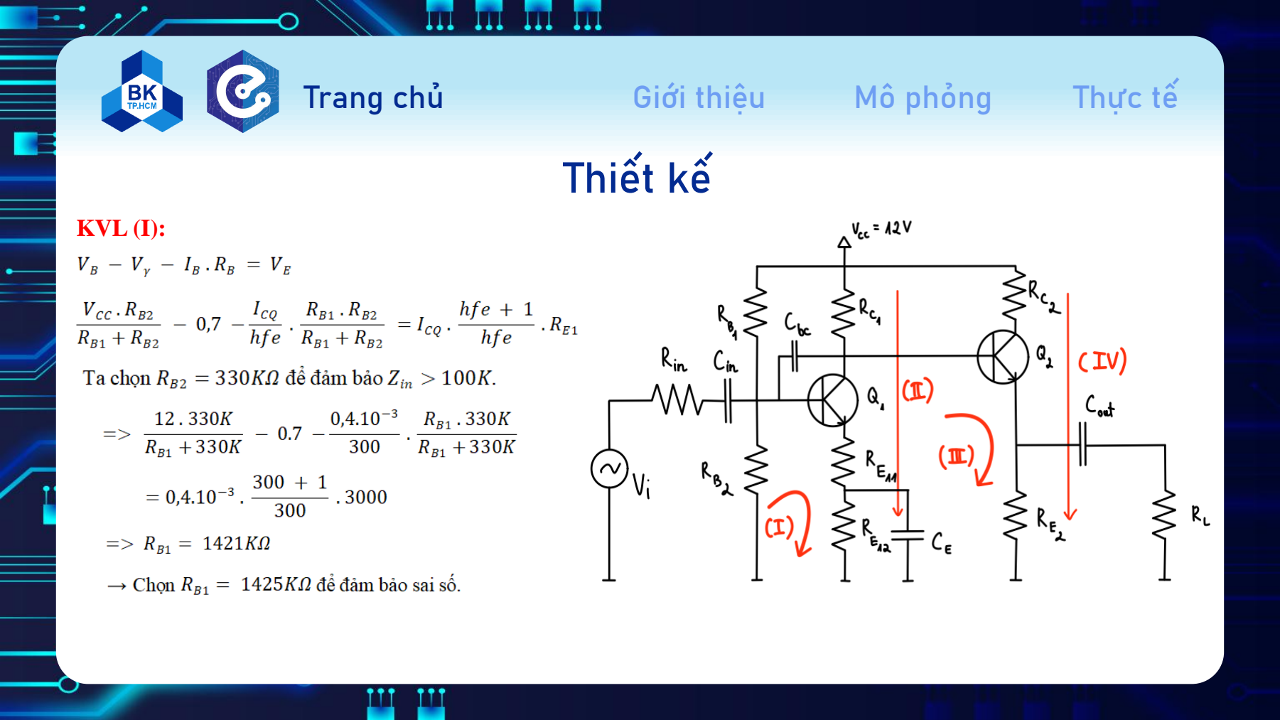
[picture p29: page 4]

Trang chủ | Giới thiệu
Mô phỏng | Thực tế

KVL (I):

## Thiết kế

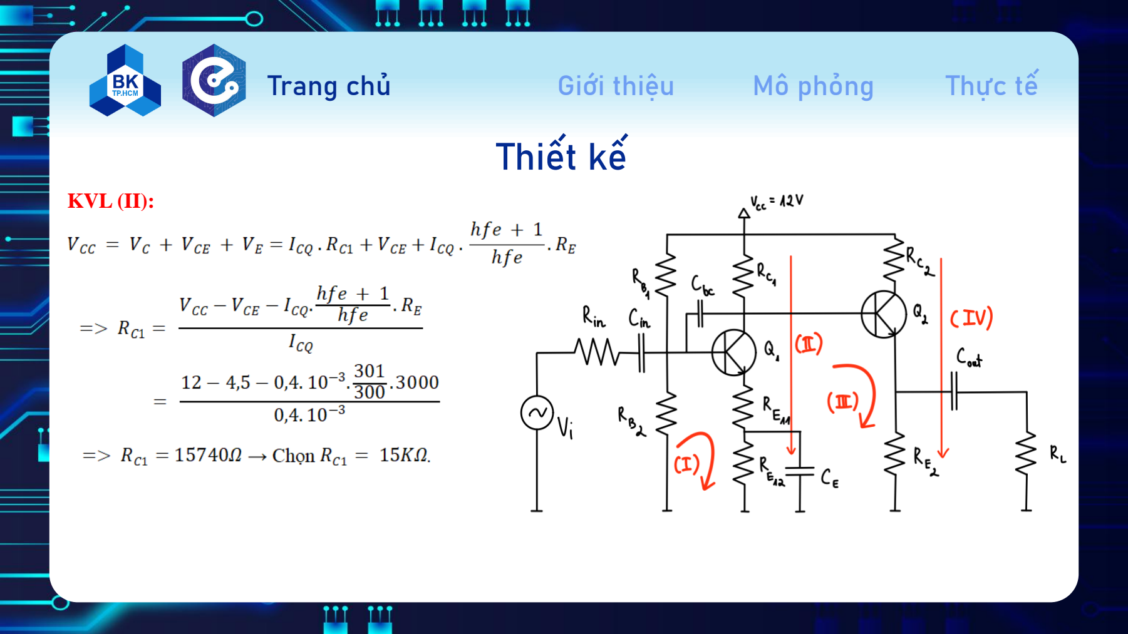
[picture p30: page 5]

Trang chủ | Giới thiệu
Mô phỏng | Thực tế

KVL (I
I

):

## Thiết kế

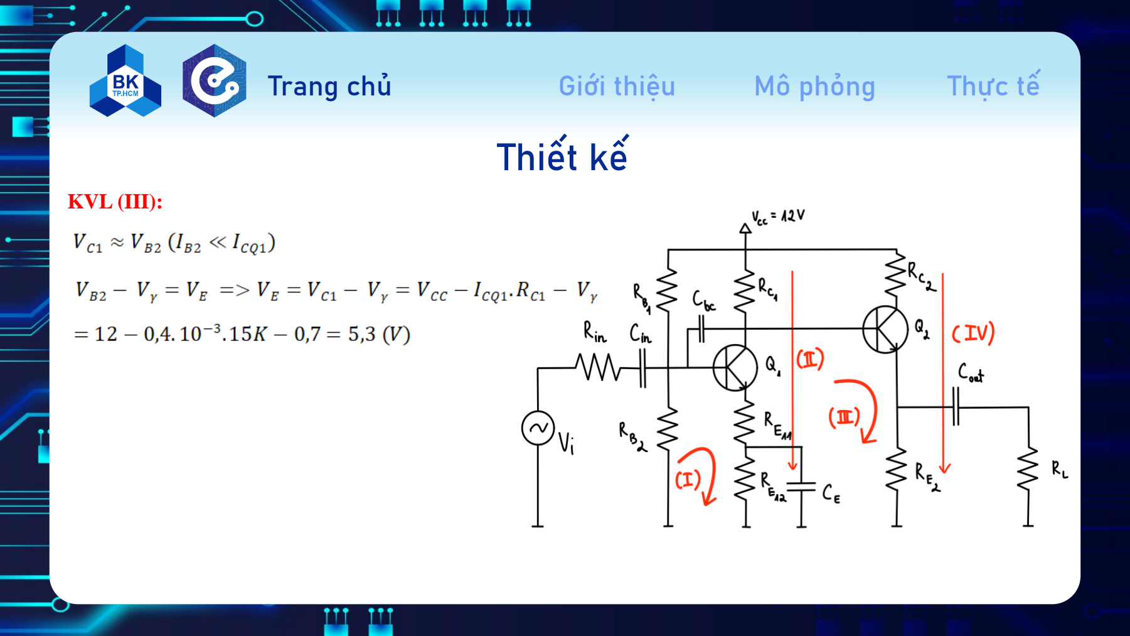
[picture p31: page 6]

Trang chủ | Giới thiệu
Mô phỏng | Thực tế

KVL (III):

## Thiết kế

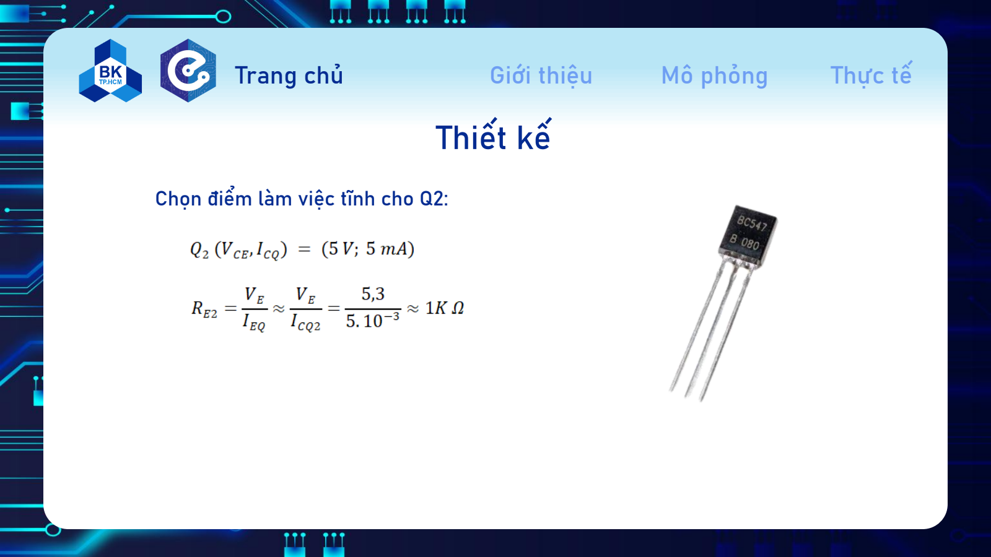
[picture p32: page 7]

Trang chủ

Chọn điểm làm việc tĩnh cho Q2:

Giới thiệu

Mô phỏng Thực tế

## Thiết kế

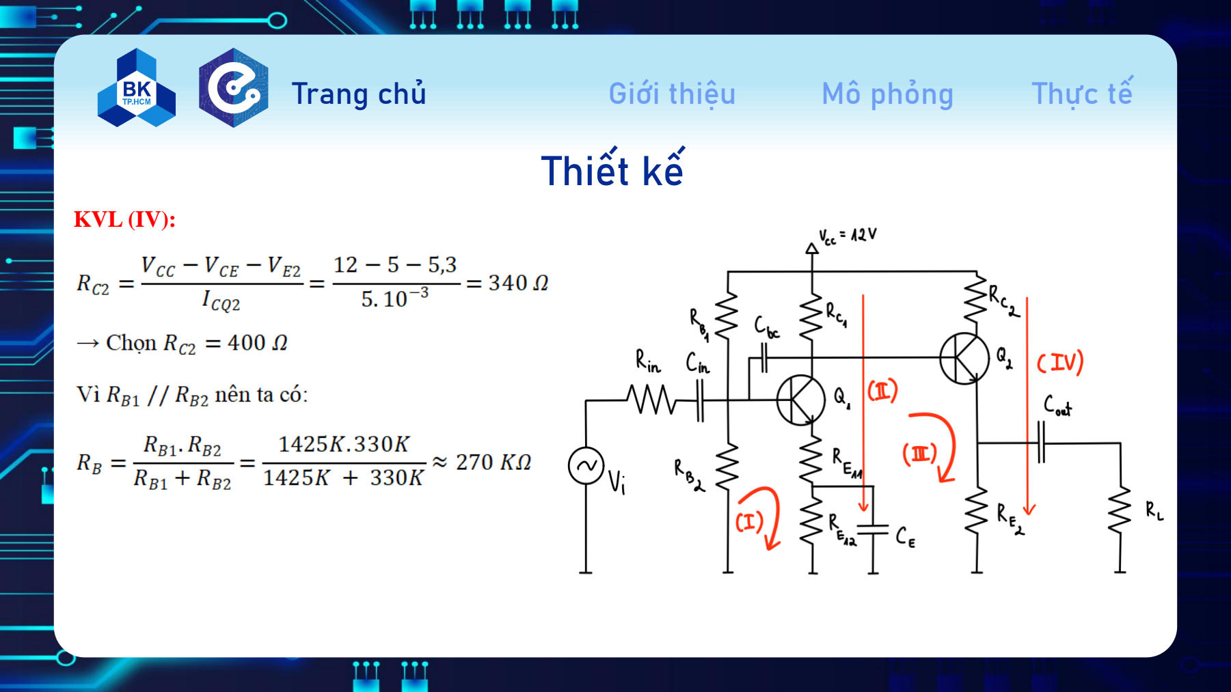
[picture p33: page 8]

Trang chủ | Giới thiệu
Mô phỏng | Thực tế

KVL (IV):

## Thiết kế

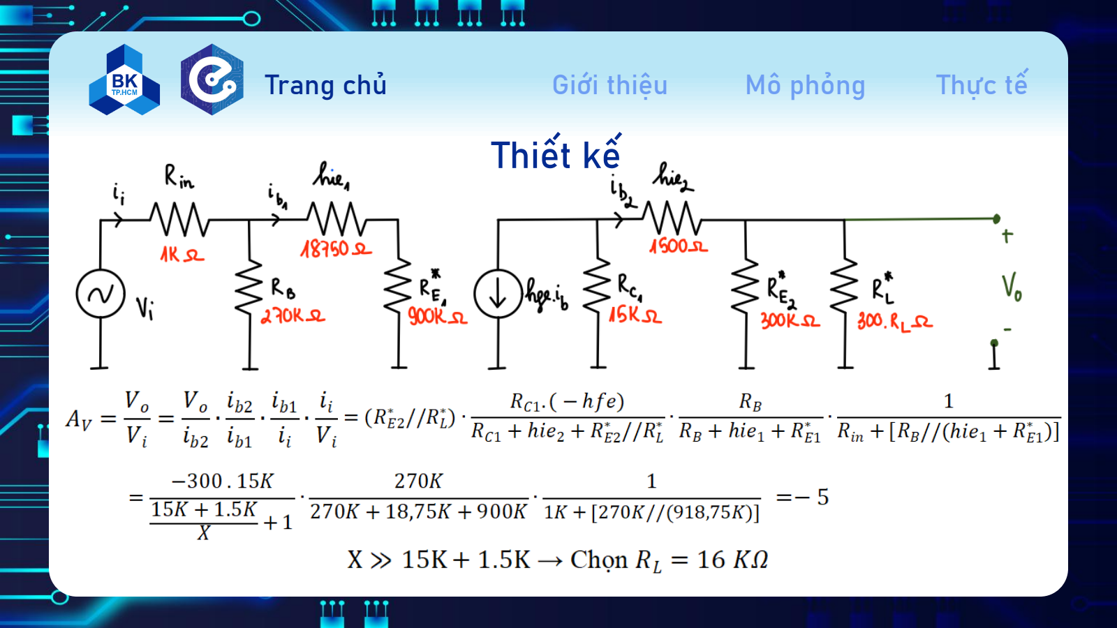
[picture p34: page 9]

Trang chủ | Giới thiệu
Mô phỏng | Thực tế

## Thiết kế

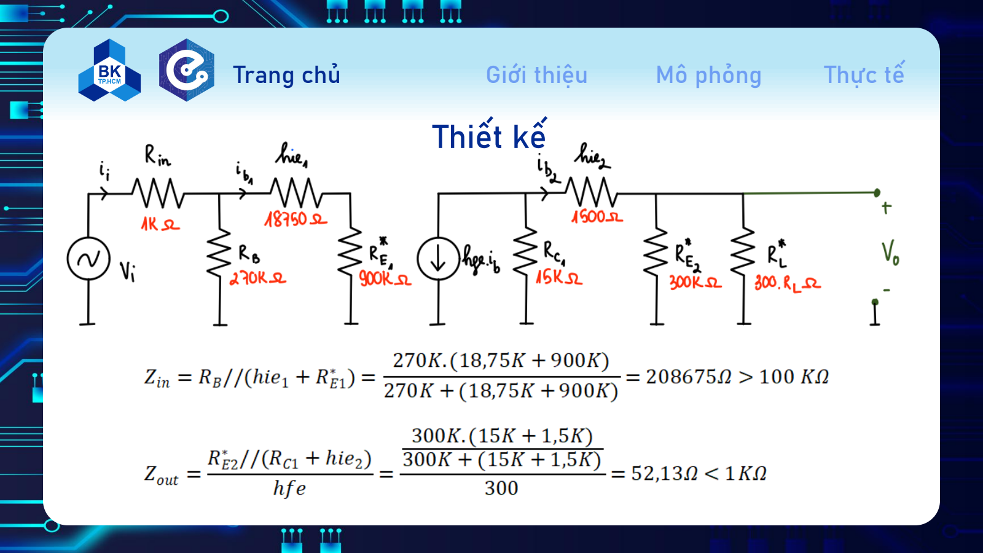
[picture p35: page 10]

Trang chủ | Giới thiệu | Mô phỏng | Thực tế

## Thiết kế

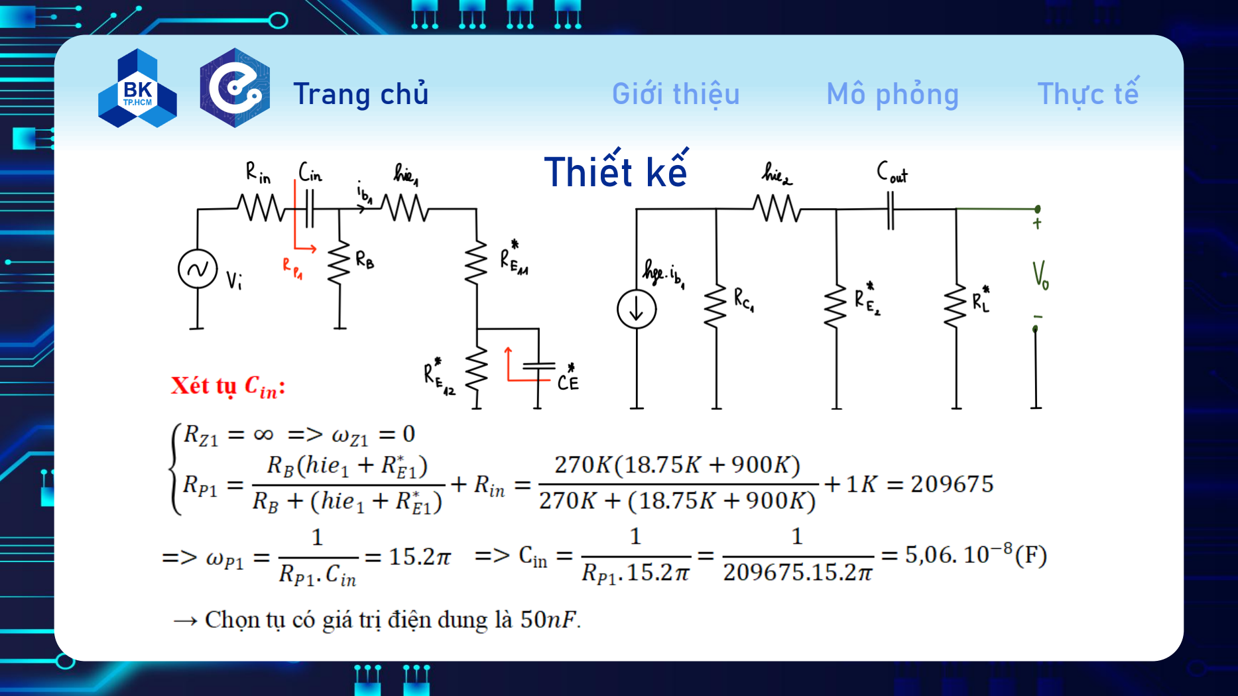
[picture p36: page 11]

Trang chủ | Giới thiệu | Mô phỏng | Thực tế

## Thiết kế

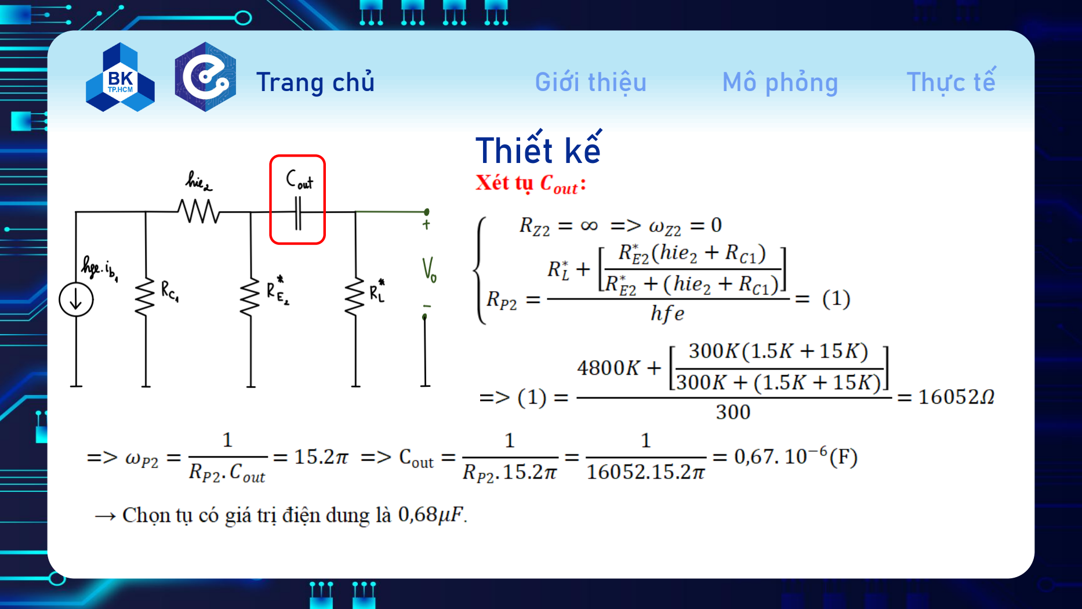
[picture p37: page 12]

s

Trang chủ | Giới thiệu | Mô phỏng | Thực tế

## Thiết kế

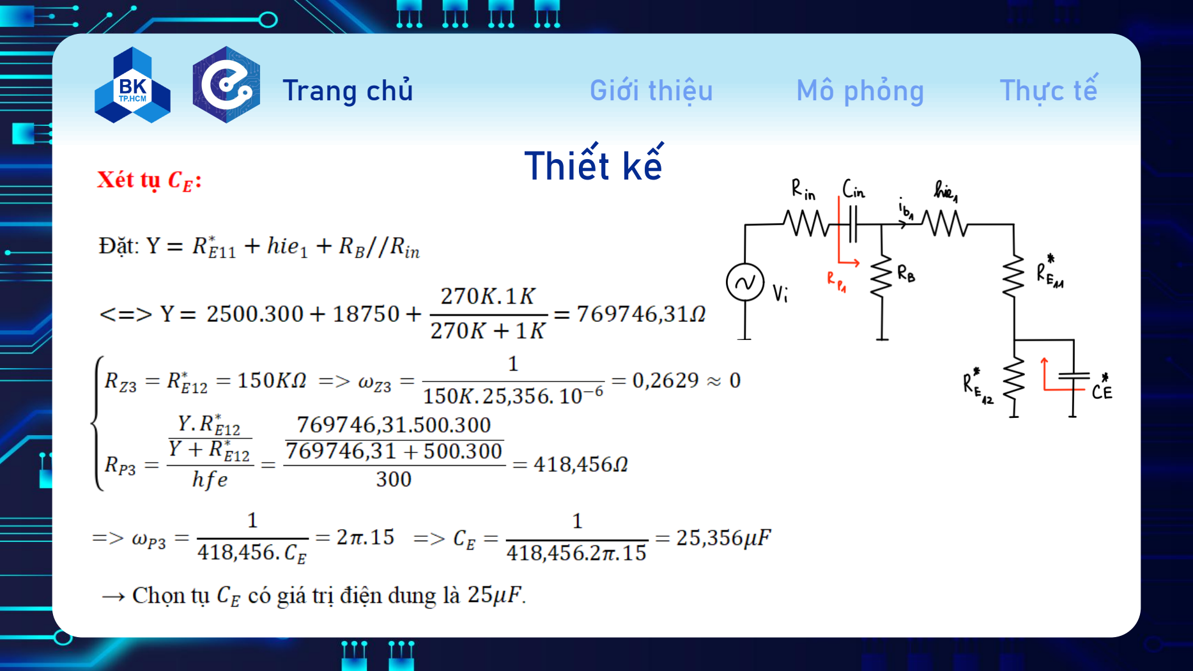
[picture p38: page 13]

Trang chủ | Giới thiệu | Mô phỏng | Thực tế

Trang chủ | Giới thiệu | Mô phỏng | Thực tế

## Thiết kế

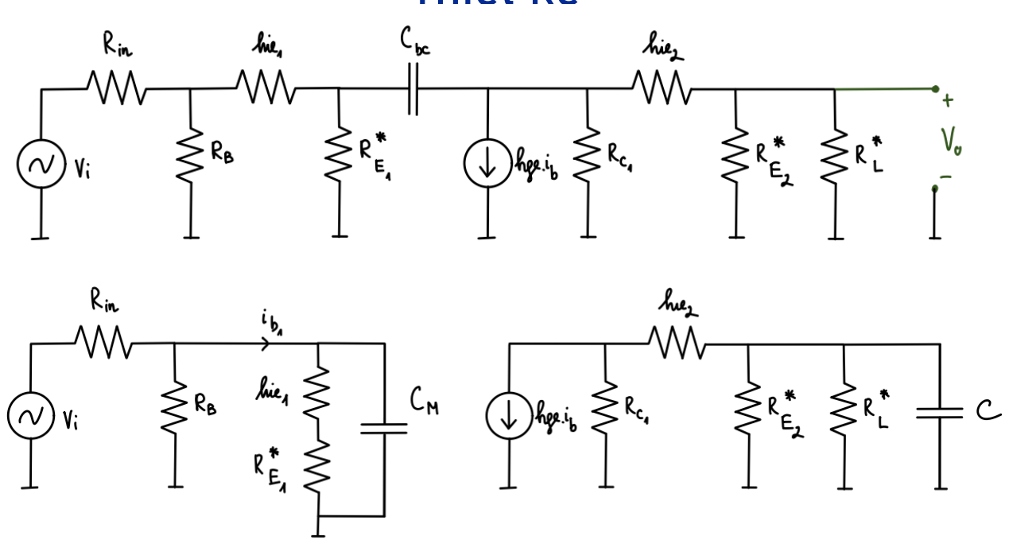
[picture p39: figure]

## Thiết kế

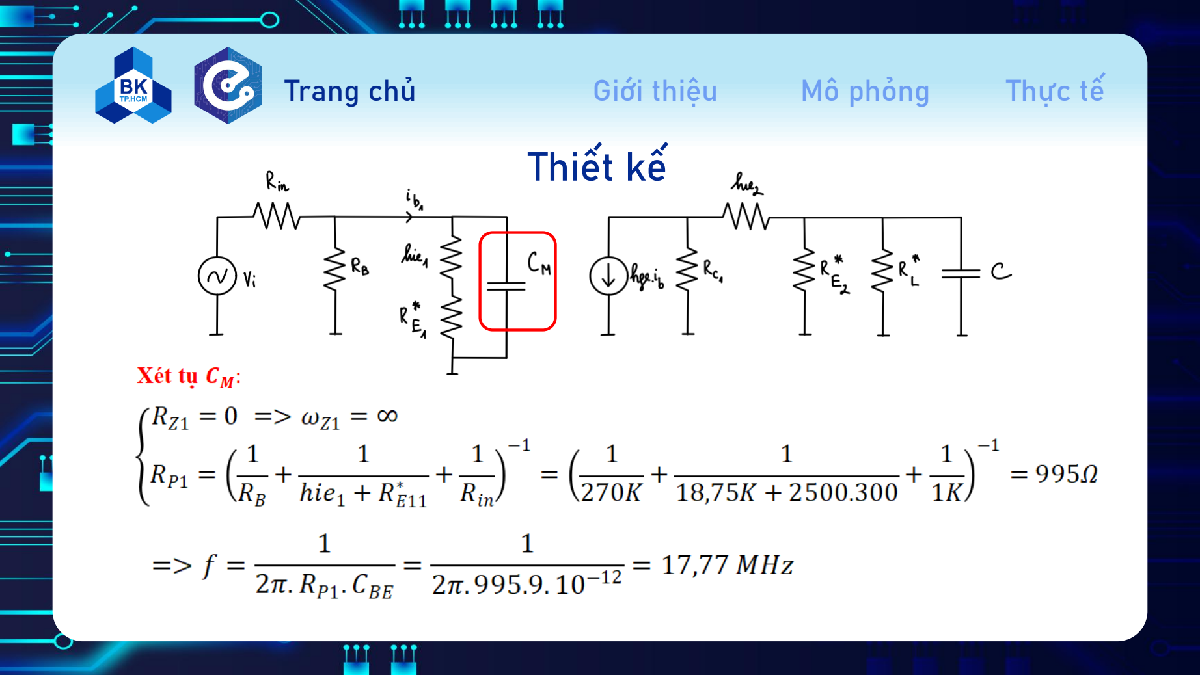
[picture p40: page 15]

Trang chủ | Giới thiệu | Mô phỏng | Thực tế

Trang chủ | Giới thiệu | Mô phỏng | Thực tế

## Thiết kế

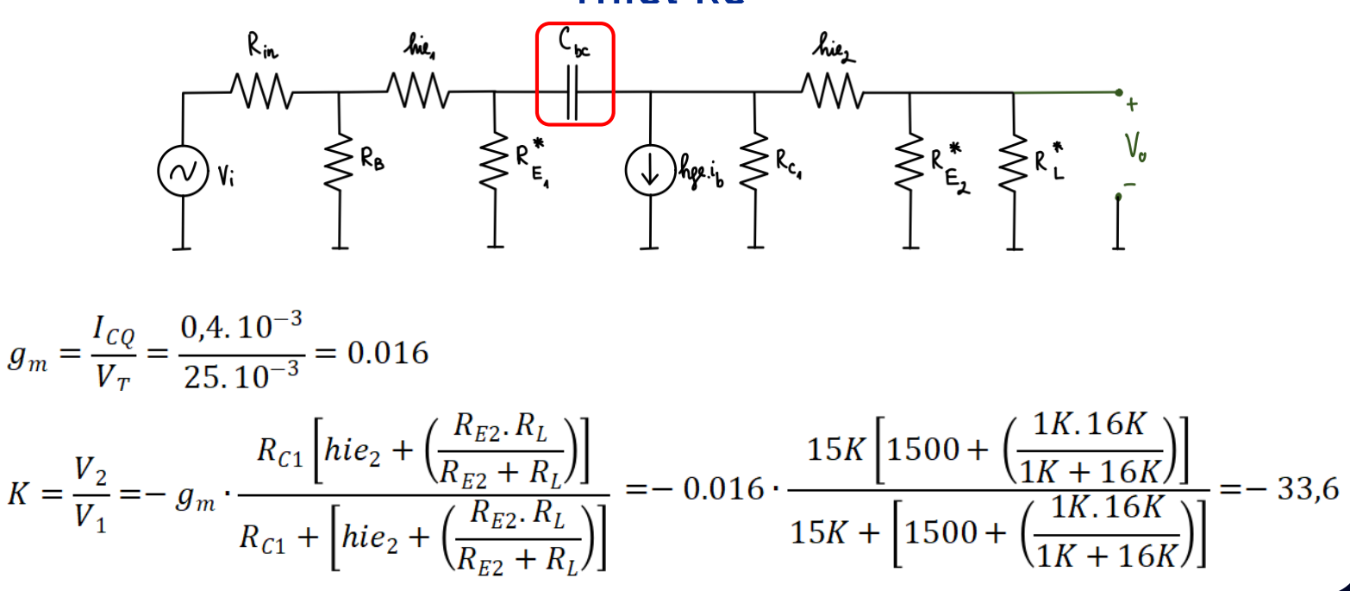
[picture p41: figure]

## Thiết kế

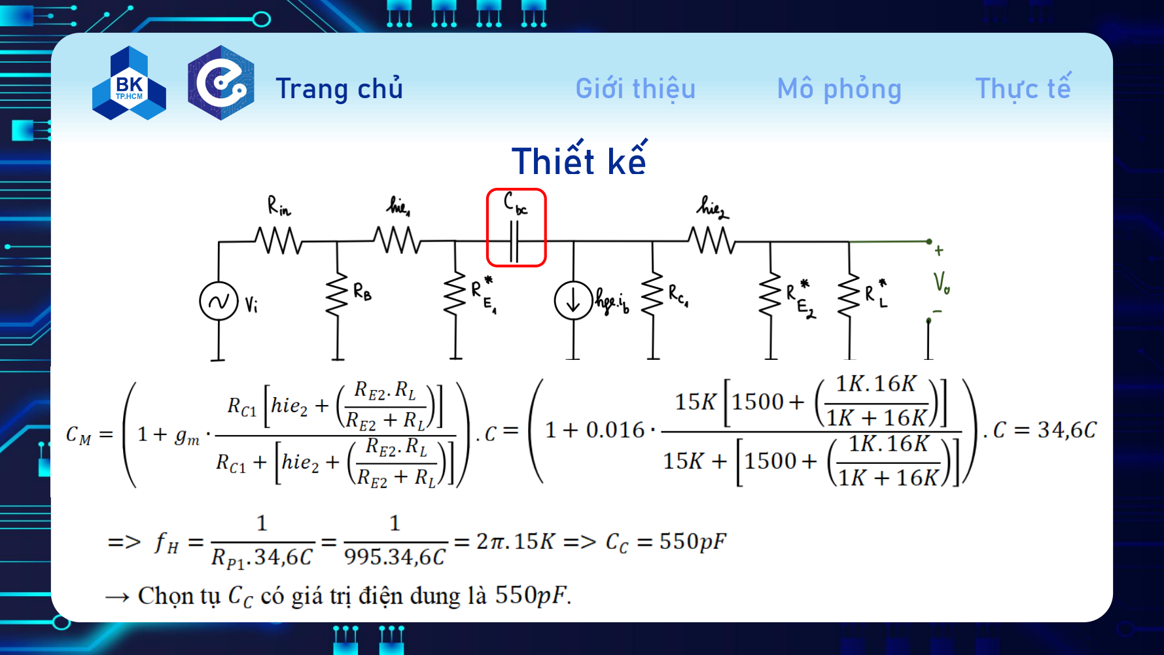
[picture p42: page 17]

Trang chủ | Giới thiệu | Mô phỏng | Thực tế

## Mô phỏng

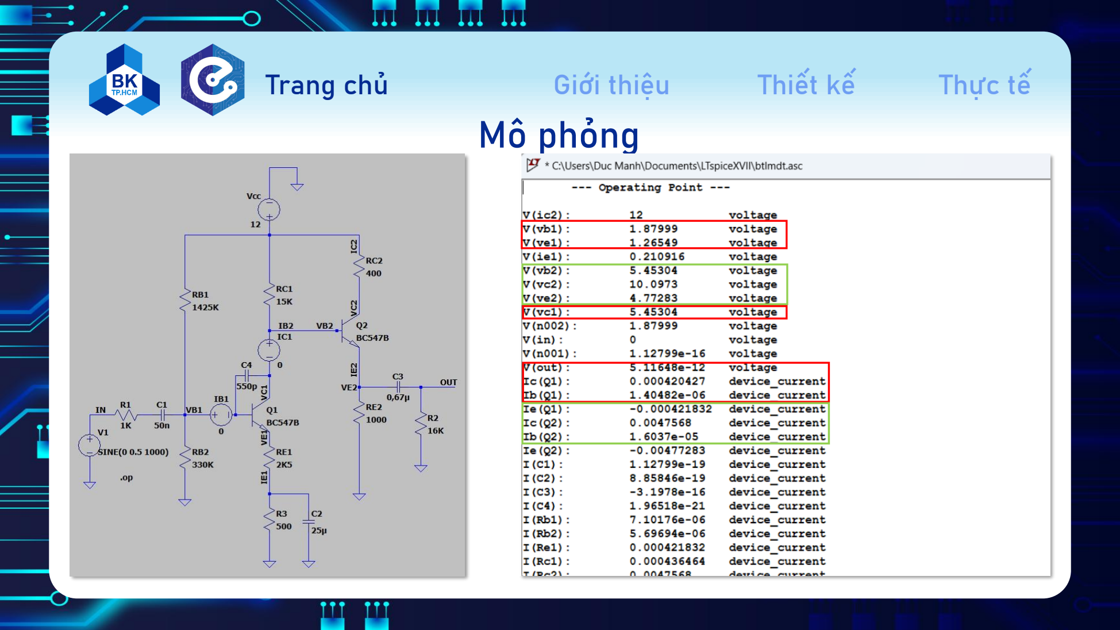
[picture p43: page 18]

Trang chủ

Giới thiệu | Thiết kế | Thực tế

## Mô phỏng

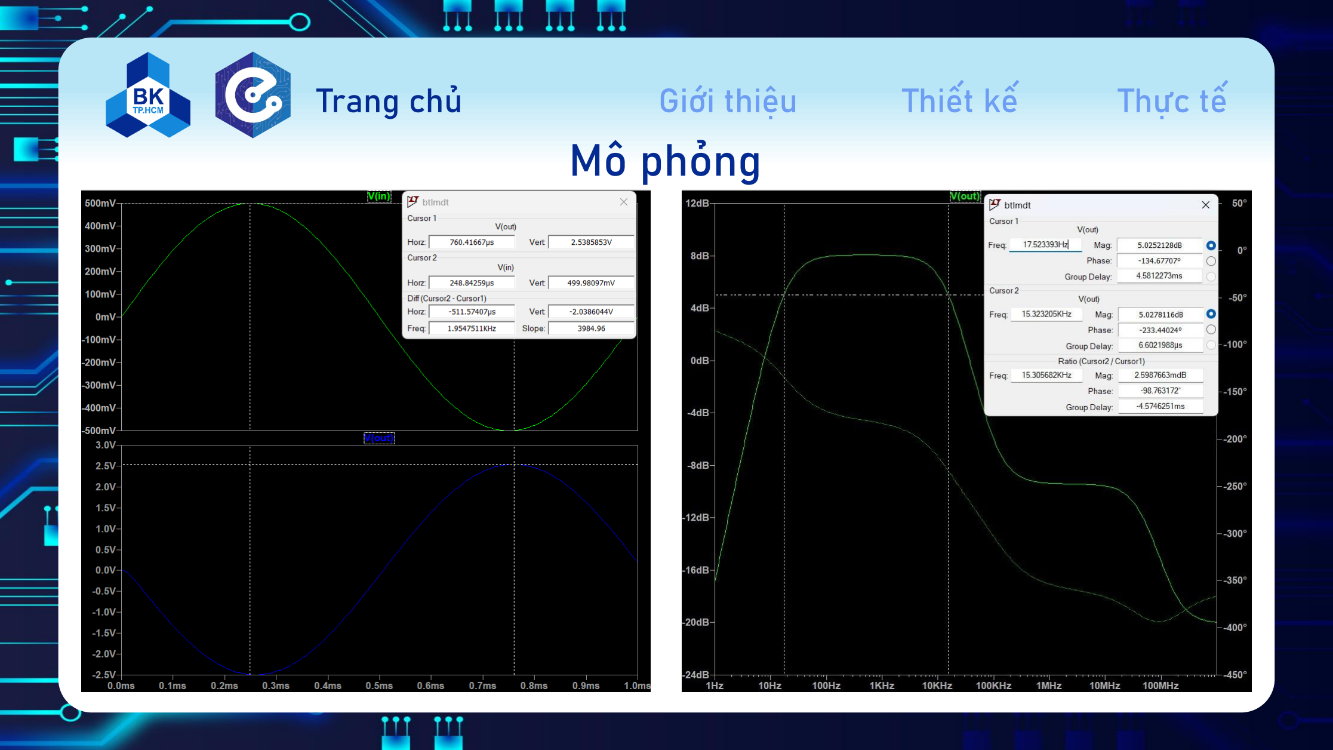
[picture p44: page 19]

Trang chủ

Giới thiệu | Thiết kế | Thực tế

## Thực tế

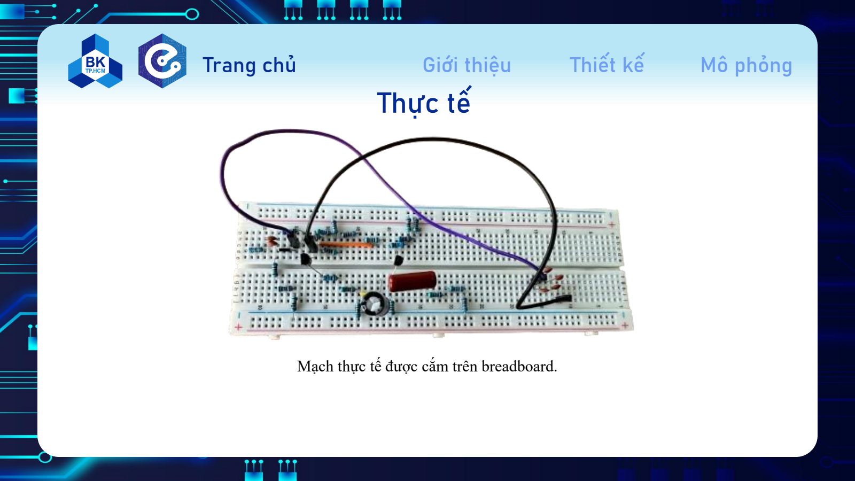
[picture p45: page 20]

Trang chủ

Giới thiệu | Thiết kế | Mô phỏng

Mạch thực tế được cắm trên breadboard.

Trang chủ

## Thực tế

Giới thiệu | Thiết kế | Mô phỏng

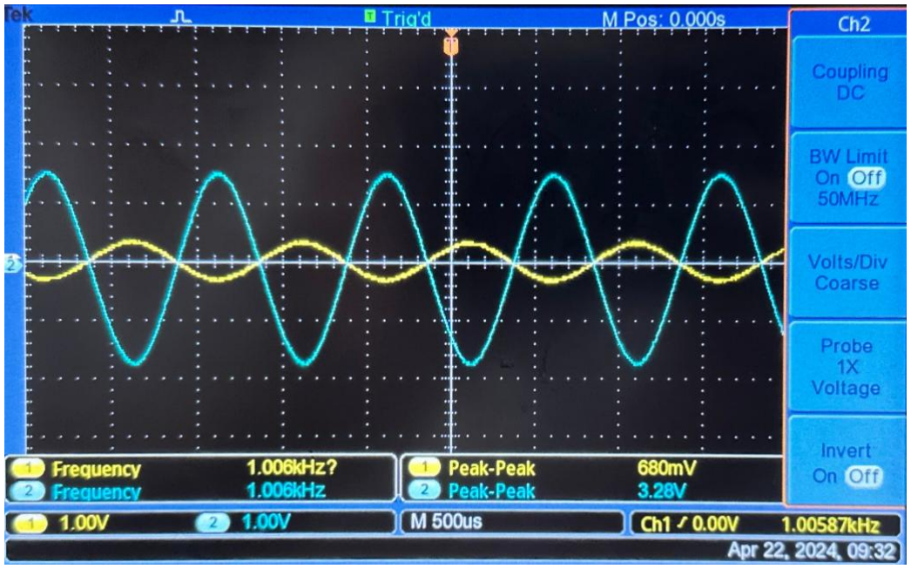
[picture p46: figure]

Độ lợi lớn nhất thu được trên Oscilloscope.

## Thực tế

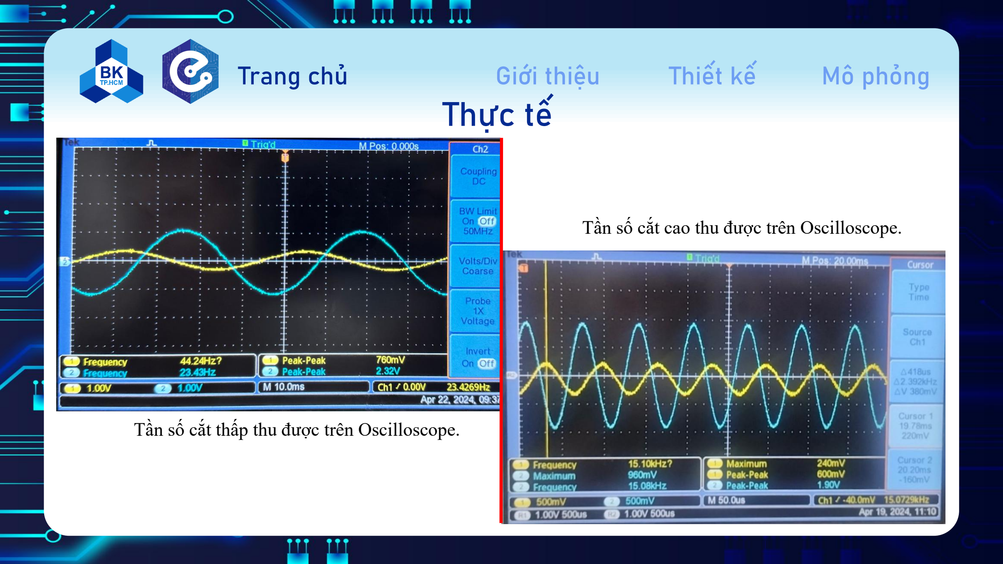
[picture p47: page 22]

Trang chủ

Giới thiệu | Thiết kế | Mô phỏng

Tần số cắt thấp thu được trên Oscilloscope.

Tần số cắt cao thu được trên Oscilloscope.

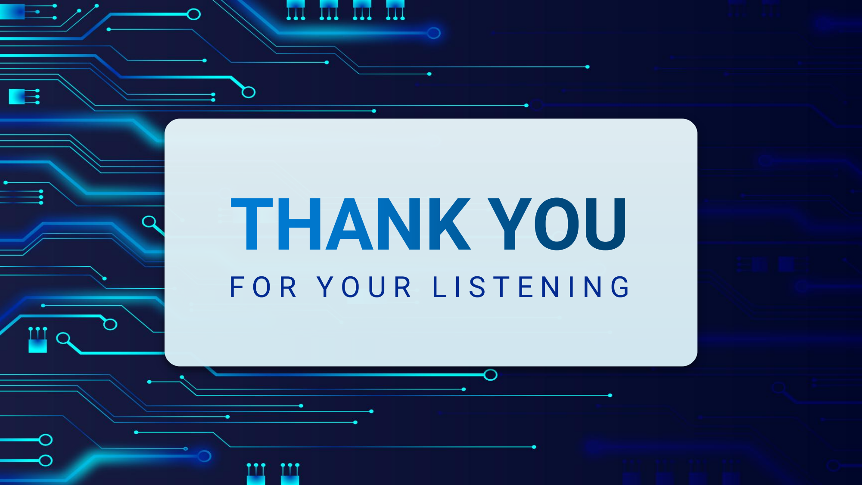
[picture p48: page 23]
