HoHiep228/Project_Design-and-implementation-of-an-amplifier-circuit/Simulation/Bandwidth.jpg

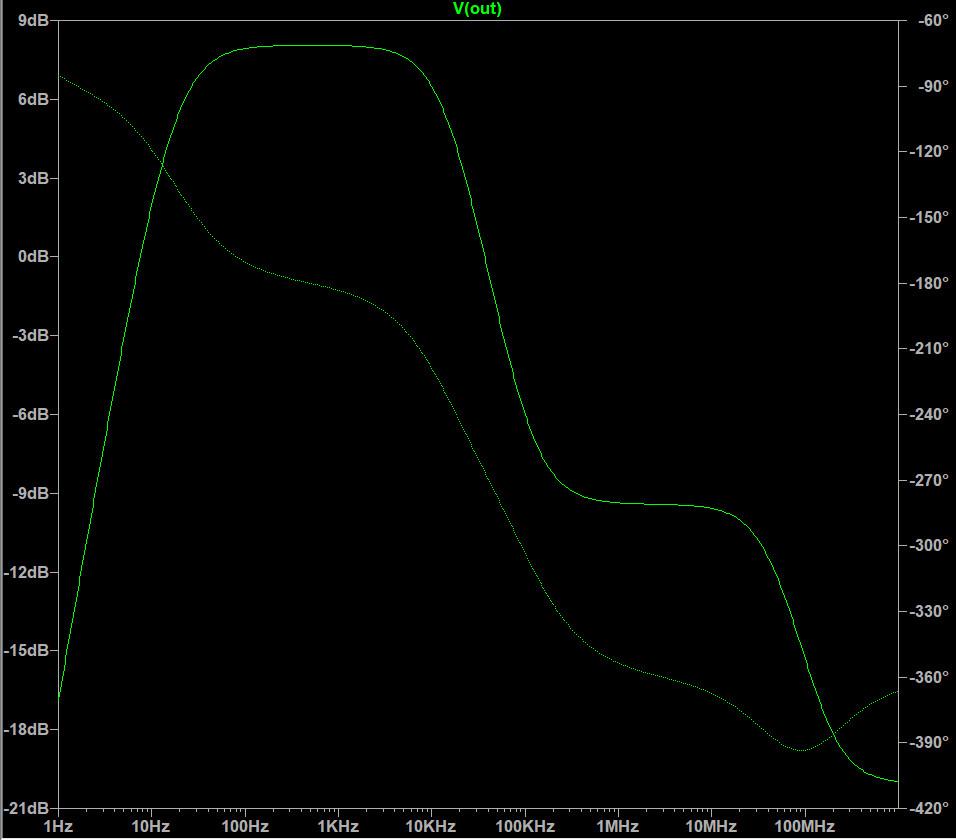
Simulation/Bandwidth.jpg
