HoHiep228/Project_Design-and-implementation-of-an-amplifier-circuit/Simulation/High and Low Crossover Frequency.jpg

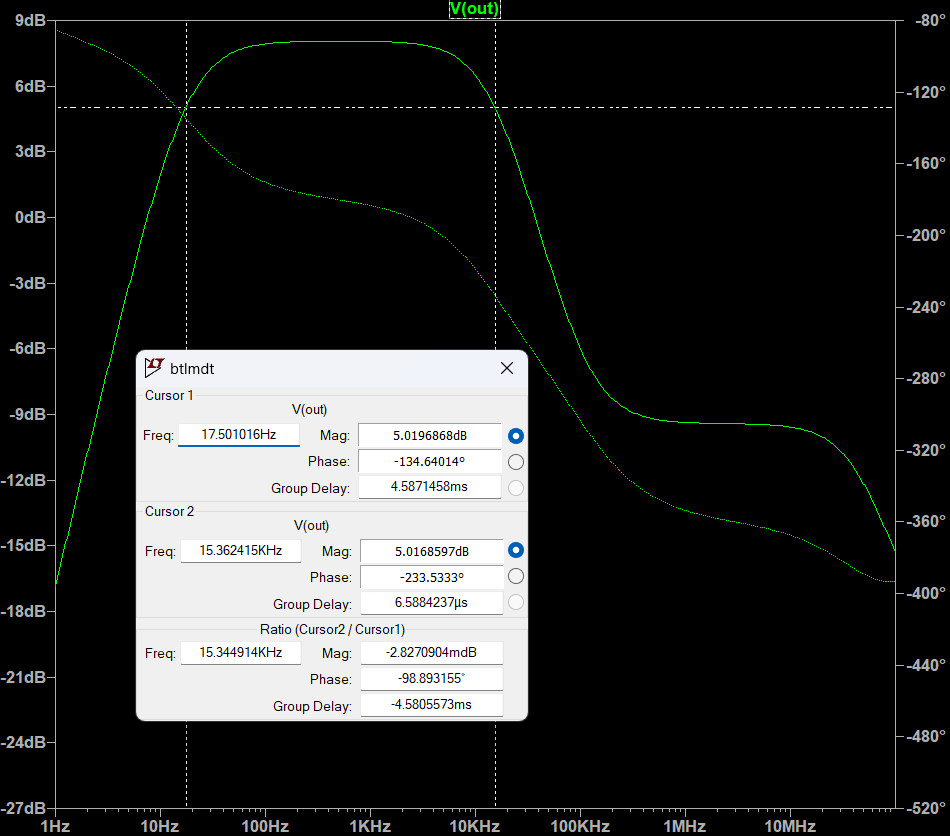
Simulation/High and Low Crossover Frequency.jpg
