HoHiep228/Project_Design-and-implementation-of-an-amplifier-circuit/Simulation/Voltage Gain.jpg

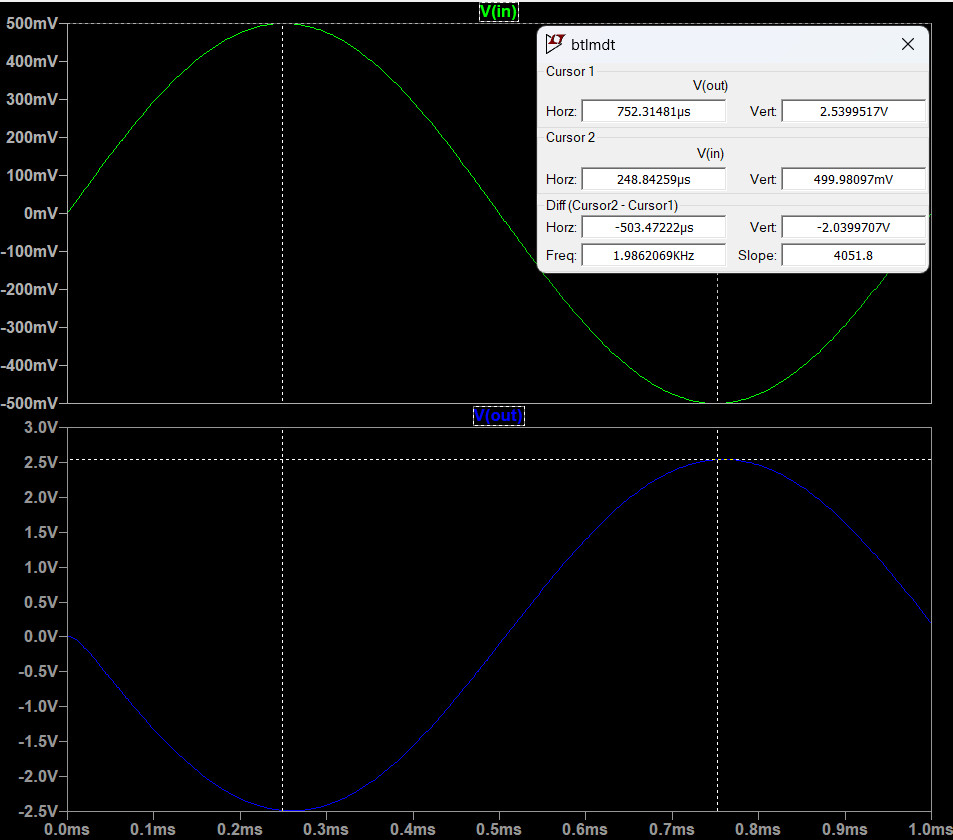
Simulation/Voltage Gain.jpg
