HoHiep228/Project_Design-and-implementation-of-an-amplifier-circuit/Simulation/Simulation.asc

C1: cap; 50n
C2: cap; 25µ
C3: cap; 0,67µ
C4: cap; 550p; V=50 Irms=0 Rser=0.1122 Lser=324p
IB1: voltage; 0
IC1: voltage; 0
Q1: npn; BC547B
Q2: npn; BC547B
R1: res; 1K
R2: res; 16K
R3: res; 500
RB1: res; 1425K
RB2: res; 330K
RC1: res; 15K
RC2: res; 400
RE1: res; 2K5
RE2: res; 1000
V1: voltage; SINE(0 0.5 1000)
Vcc: voltage; 12
Named nets: 0, VE1, VB1, VC2, VE2, VB2, IC2, IE2, IB2, IE1, VC1, IN, OUT
.op
